cpumons/OTTOdiy/OttoDIY_PLUS_all/05_Papercraft & share/OttoDIY_papercraft_captain_A4.jpg

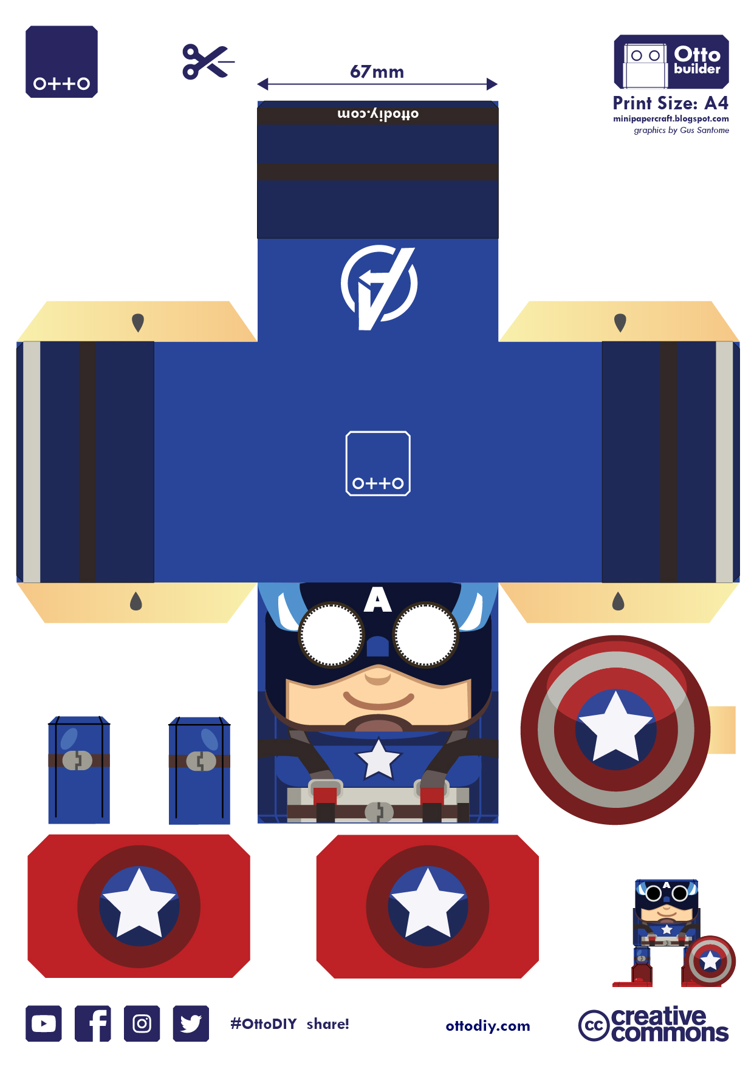
OttoDIY_PLUS_all/05_Papercraft & share/OttoDIY_papercraft_captain_A4.jpg
