cpumons/OTTOdiy/OttoDIY_PLUS_all/05_Papercraft & share/OttoDIY_papercraft_ironman_A4.jpg

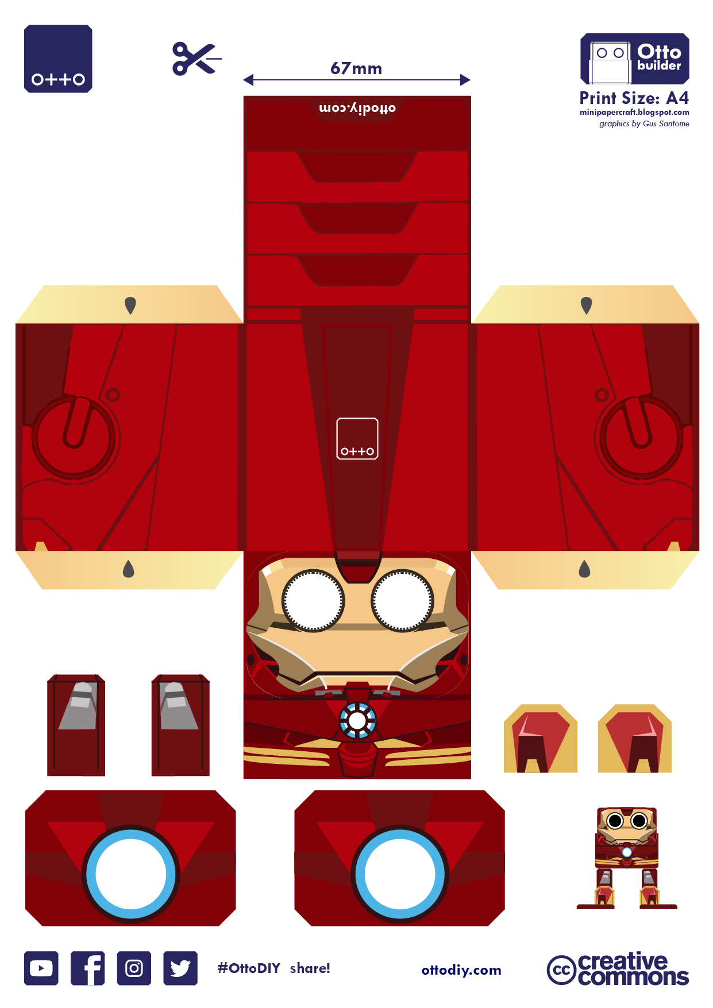
OttoDIY_PLUS_all/05_Papercraft & share/OttoDIY_papercraft_ironman_A4.jpg
