cpumons/OTTOdiy/OttoDIY_PLUS_all/05_Papercraft & share/OttoDIY_papercraft_minion_A4.jpg.jpg

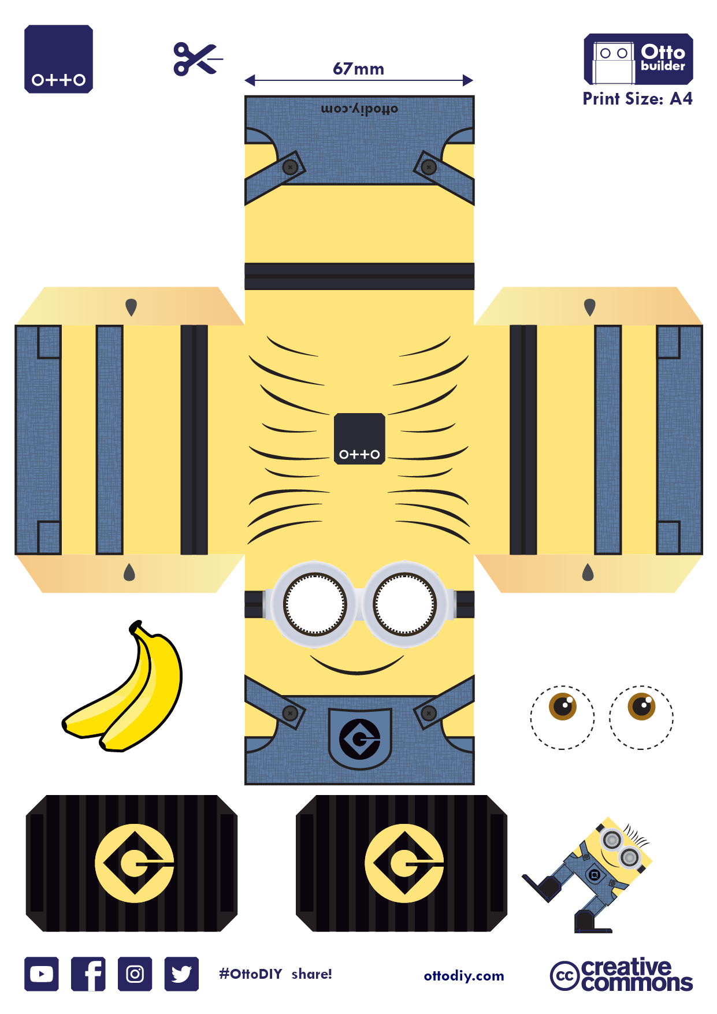
OttoDIY_PLUS_all/05_Papercraft & share/OttoDIY_papercraft_minion_A4.jpg.jpg
