cpumons/OTTOdiy/OttoDIY_PLUS_all/3D print/accessories/OttoDIY_Elf.stl

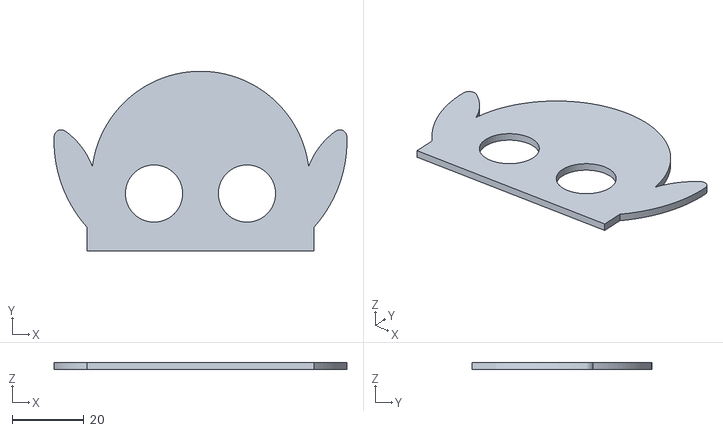
[picture p14: CAD file, 2019-02-06]
OttoDIY_PLUS_all/3D print/accessories/OttoDIY_Elf.stl
81.9 x 50.2 x 2.00
