cpumons/OTTOdiy/OttoDIY_PLUS_all/3D print/OttoDIY+_body_v08.stl

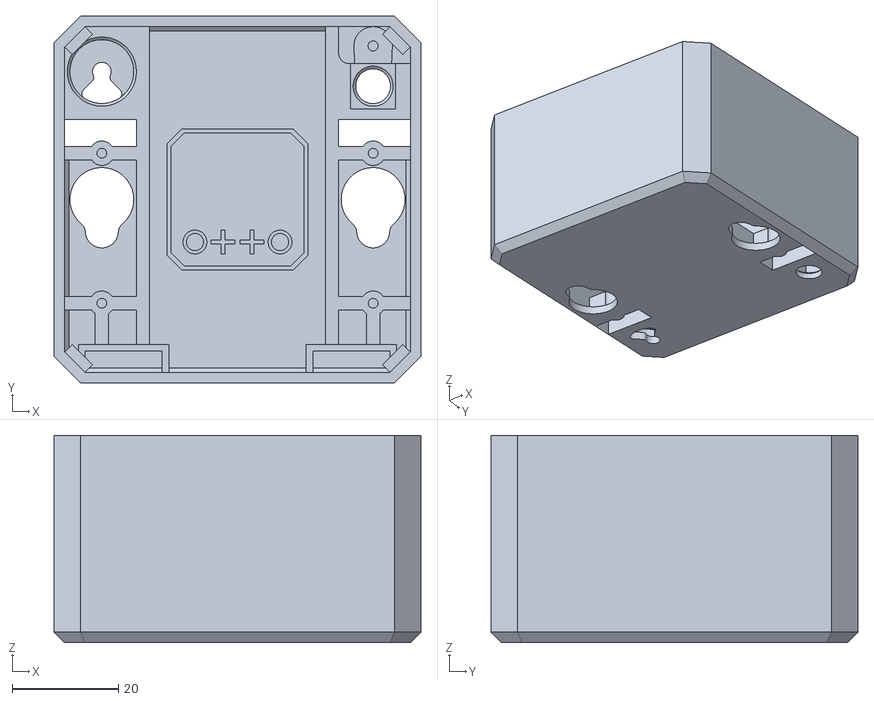
[picture p15: CAD file, 2019-02-06]
OttoDIY_PLUS_all/3D print/OttoDIY+_body_v08.stl
69.0 x 69.0 x 39.0
