cpumons/OTTOdiy/OttoDIY_PLUS_all/3D print/accessories/OttoDIY_Stitches.stl

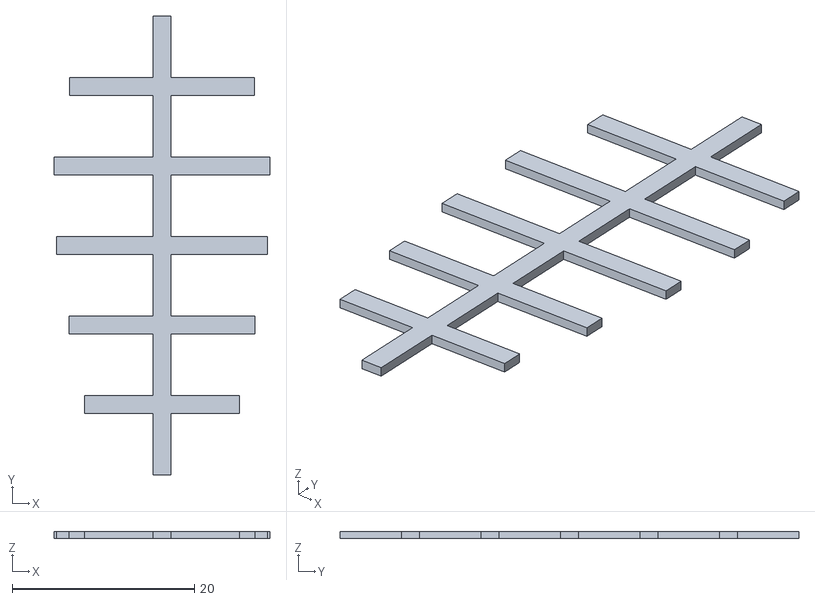
[picture p16: CAD file, 2019-02-06]
OttoDIY_PLUS_all/3D print/accessories/OttoDIY_Stitches.stl
23.7 x 50.3 x 0.8
