cpumons/OTTOdiy/OttoDIY_PLUS_all/3D print/OttoDIY+_head_v08.stl

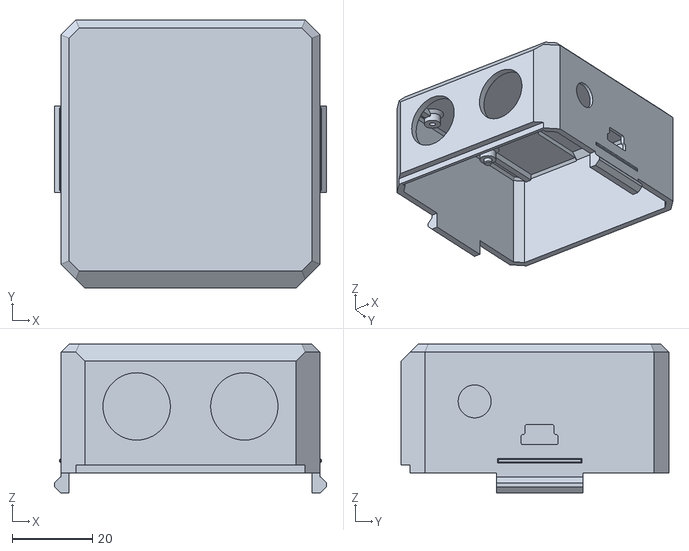
[picture p17: CAD file, 2019-02-06]
OttoDIY_PLUS_all/3D print/OttoDIY+_head_v08.stl
67.6 x 66.7 x 37.0
