cpumons/OTTOdiy/OttoDIY_PLUS_all/3D print/accessories/OttoDIY_superhero.stl

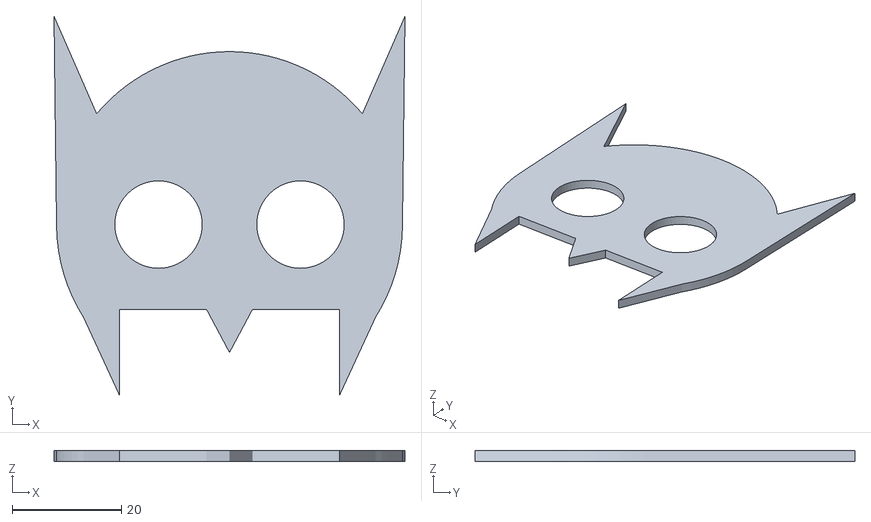
[picture p18: CAD file, 2019-02-06]
OttoDIY_PLUS_all/3D print/accessories/OttoDIY_superhero.stl
64.3 x 69.5 x 2.00
