cpumons/OTTOdiy/OttoDIY_PLUS_all/3D print/OttoDIY+_Leg_v08.stl

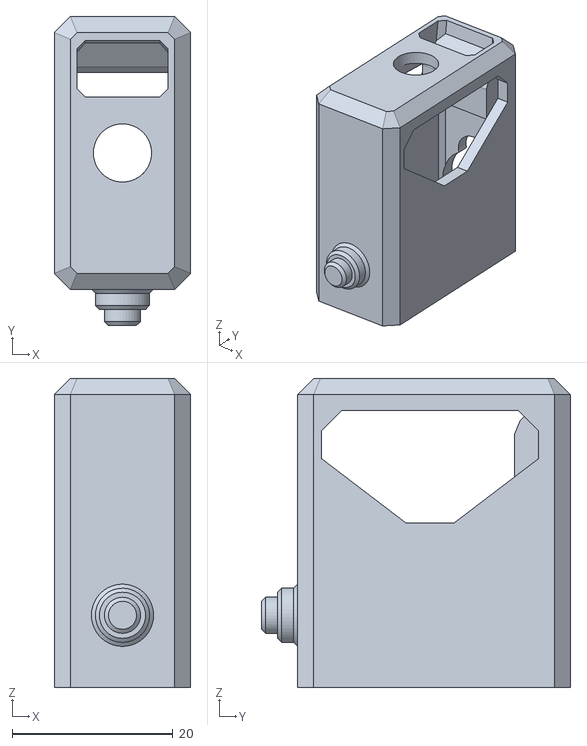
[picture p19: CAD file, 2019-02-06]
OttoDIY_PLUS_all/3D print/OttoDIY+_Leg_v08.stl
17.0 x 38.5 x 38.5
