cpumons/OTTOdiy/OttoDIY_PLUS_all/3D print/accessories/OttoDIY_Kitty.stl

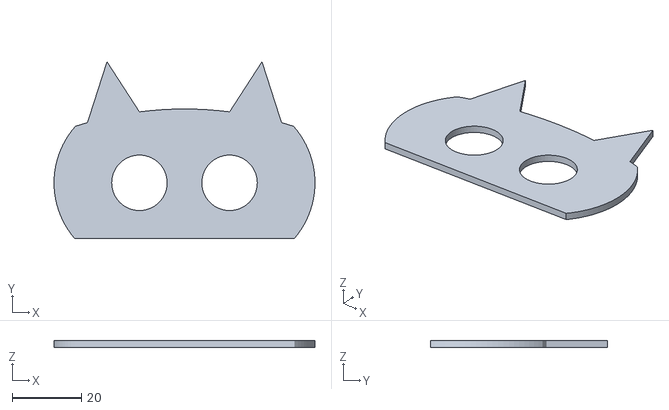
[picture p20: CAD file, 2019-02-06]
OttoDIY_PLUS_all/3D print/accessories/OttoDIY_Kitty.stl
75.3 x 50.9 x 2.00
