cpumons/OTTOdiy/OttoDIY_PLUS_all/3D print/OttoDIY+_foot_v08.stl

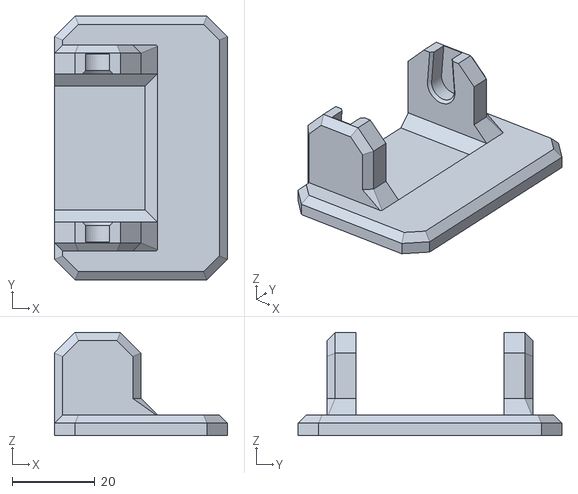
[picture p21: CAD file, 2019-02-06]
OttoDIY_PLUS_all/3D print/OttoDIY+_foot_v08.stl
42.0 x 64.0 x 25.0
