cpumons/OTTOdiy/OttoDIY_PLUS_all/3D print/accessories/OttoDIY_Skull.stl

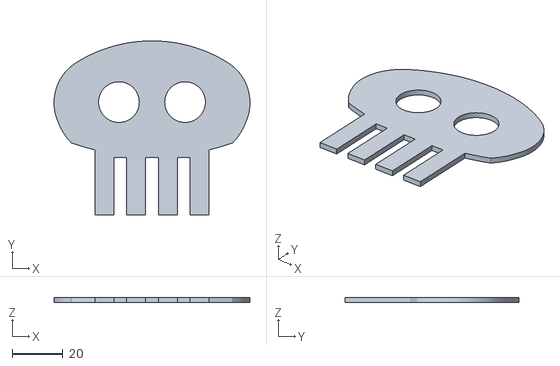
[picture p22: CAD file, 2019-02-06]
OttoDIY_PLUS_all/3D print/accessories/OttoDIY_Skull.stl
77.1 x 68.4 x 2.00
