cpumons/OTTOdiy/OttoDIY_PLUS_all/3D print/accessories/OttoDIY_RockMonster.stl

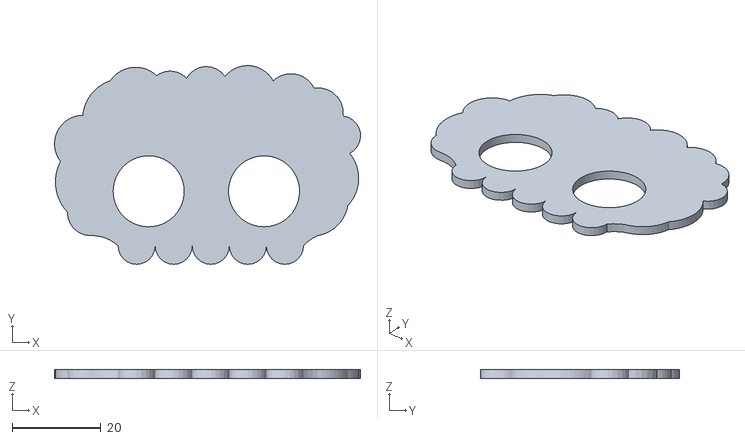
[picture p23: CAD file, 2019-02-06]
OttoDIY_PLUS_all/3D print/accessories/OttoDIY_RockMonster.stl
69.0 x 44.8 x 2.00
