cpumons/OTTOdiy/OttoDIY_PLUS_all/3D print/accessories/OttoDIY_Bunny.stl

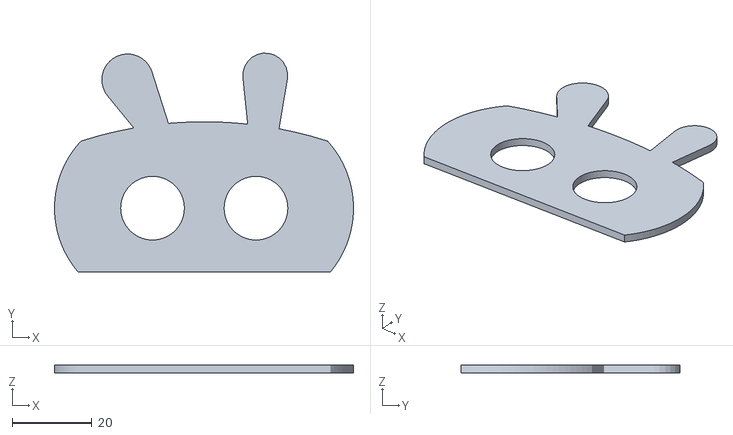
[picture p24: CAD file, 2019-02-06]
OttoDIY_PLUS_all/3D print/accessories/OttoDIY_Bunny.stl
75.1 x 55.0 x 2.00
