cpumons/OTTOdiy/OttoDIY_PLUS_all/3D print/accessories/OttoDIY_glasses.stl

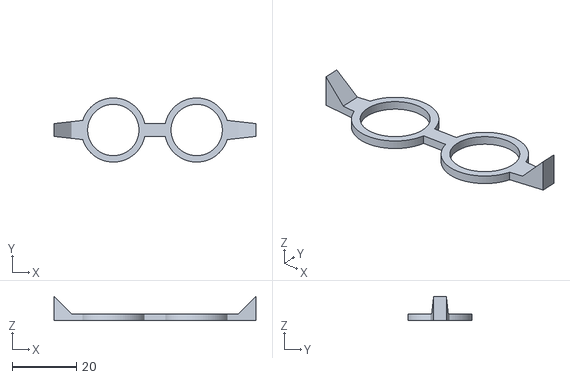
[picture p25: CAD file, 2019-02-06]
OttoDIY_PLUS_all/3D print/accessories/OttoDIY_glasses.stl
63.0 x 20.0 x 7.50
