cpumons/OTTOdiy/OttoDIY_PLUS_all/3D print/accessories/OttoDIY_lashes.stl

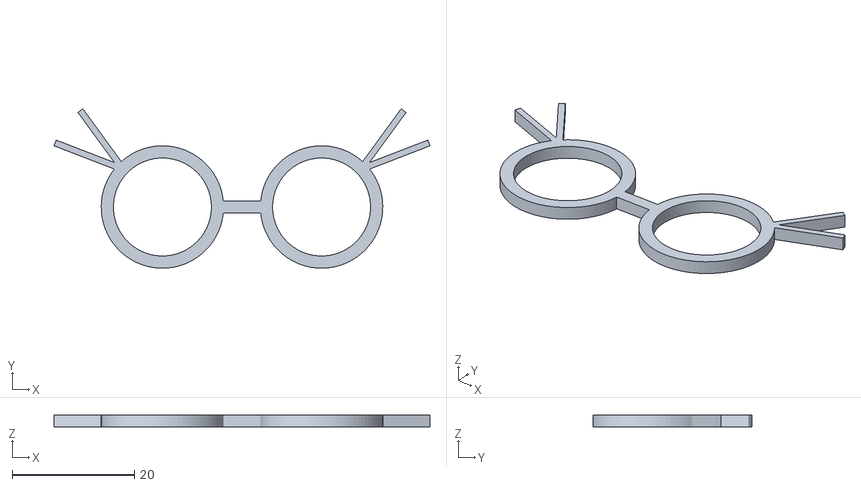
[picture p26: CAD file, 2019-02-06]
OttoDIY_PLUS_all/3D print/accessories/OttoDIY_lashes.stl
61.4 x 26.0 x 2.00
