cpumons/OTTOdiy/OttoDIY_PLUS_all/3D print/accessories/OttoDIY_AngryEyes.stl

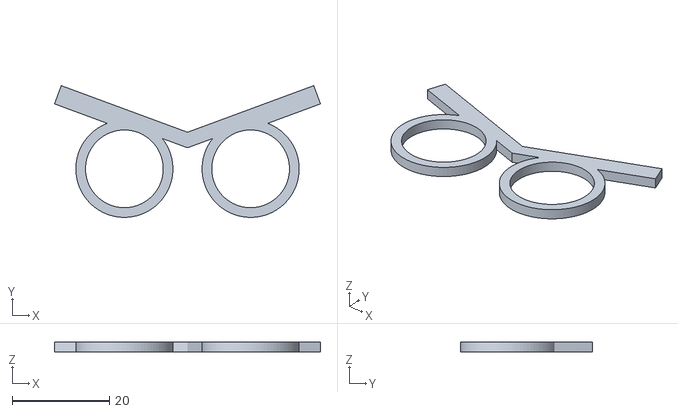
[picture p27: CAD file, 2019-02-06]
OttoDIY_PLUS_all/3D print/accessories/OttoDIY_AngryEyes.stl
54.8 x 27.1 x 2.00
