cpumons/OTTOdiy/OttoDIY_PLUS_all/3D print/accessories/OttoDIY_notHero.stl

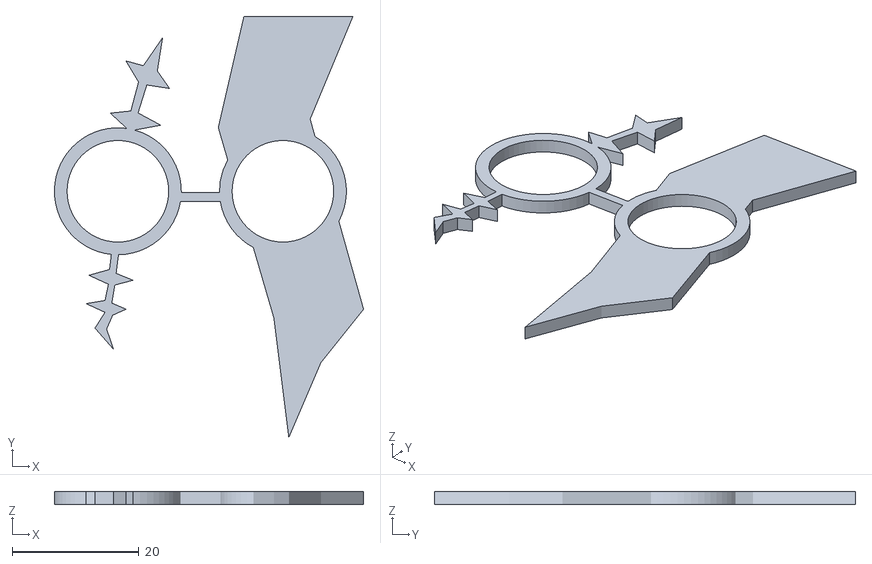
[picture p28: CAD file, 2019-02-06]
OttoDIY_PLUS_all/3D print/accessories/OttoDIY_notHero.stl
48.7 x 66.3 x 2.00
