cpumons/OTTOdiy/OttoDIY_PLUS_all/3D print/accessories/OttoDIY_pirate.stl

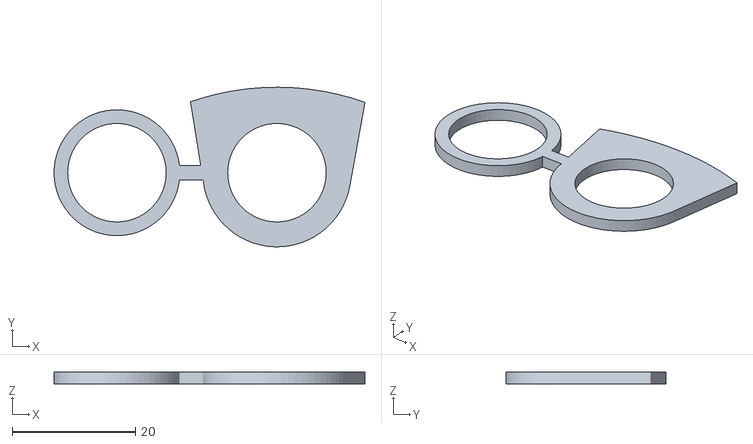
[picture p29: CAD file, 2019-02-06]
OttoDIY_PLUS_all/3D print/accessories/OttoDIY_pirate.stl
50.5 x 25.9 x 2.00
