cpumons/OTTOdiy/OttoDIY_PLUS_all/3D print/accessories/OttoDIY_superhero2.stl

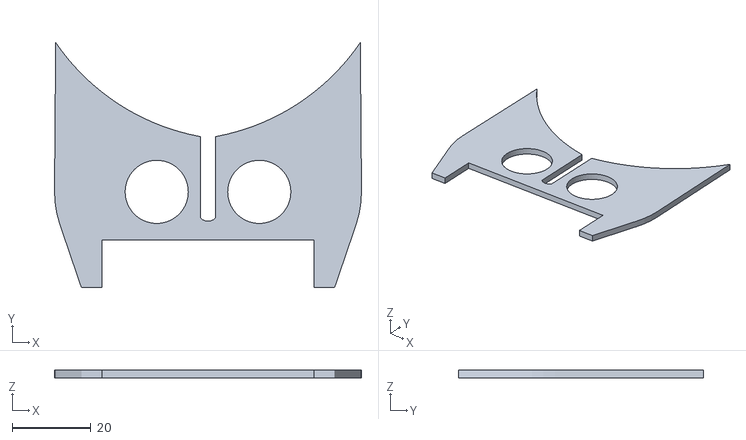
[picture p30: CAD file, 2019-02-06]
OttoDIY_PLUS_all/3D print/accessories/OttoDIY_superhero2.stl
77.8 x 62.1 x 2.00
