cpumons/OTTOdiy/OttoDIY_PLUS_all/3D print/accessories/OttoDIY_PumpkinMonster.stl

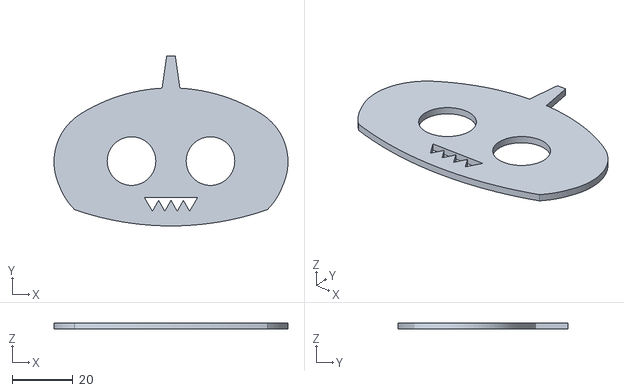
[picture p31: CAD file, 2019-02-06]
OttoDIY_PLUS_all/3D print/accessories/OttoDIY_PumpkinMonster.stl
77.1 x 55.9 x 2.00
