cpumons/OTTOdiy/OttoDIY_PLUS_all/3D print/accessories/OttoDIY_Puppy.stl

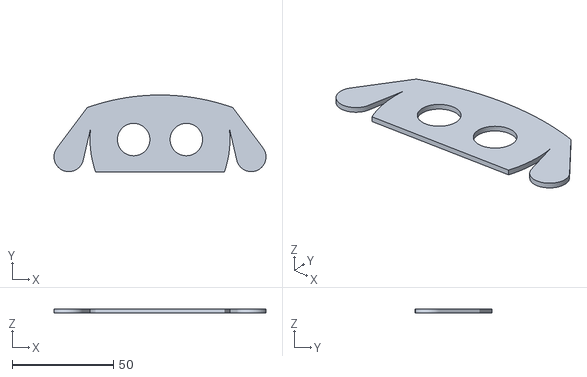
[picture p32: CAD file, 2019-02-06]
OttoDIY_PLUS_all/3D print/accessories/OttoDIY_Puppy.stl
104.6 x 38.0 x 2.00
