cpumons/OTTOdiy/OttoDIY_PLUS_all/3D print/accessories/OttoDIY_WarMask.stl

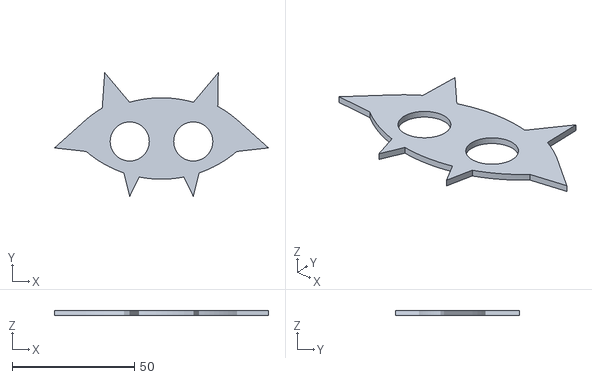
[picture p33: CAD file, 2019-02-06]
OttoDIY_PLUS_all/3D print/accessories/OttoDIY_WarMask.stl
87.6 x 50.6 x 2.00
