cpumons/OTTOdiy/OttoDIY_PLUS_all/3D print/accessories/OttoDIY_Ninja.stl

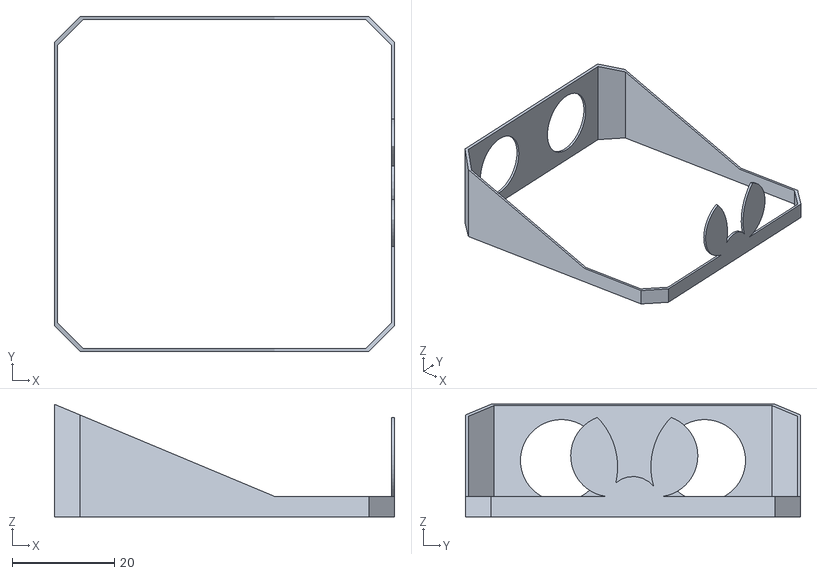
[picture p34: CAD file, 2019-02-06]
OttoDIY_PLUS_all/3D print/accessories/OttoDIY_Ninja.stl
66.5 x 65.5 x 22.0
