cpumons/OTTOdiy/OttoDIY_PLUS_all/OttoDIY+_InstructionsManual_V05.pdf

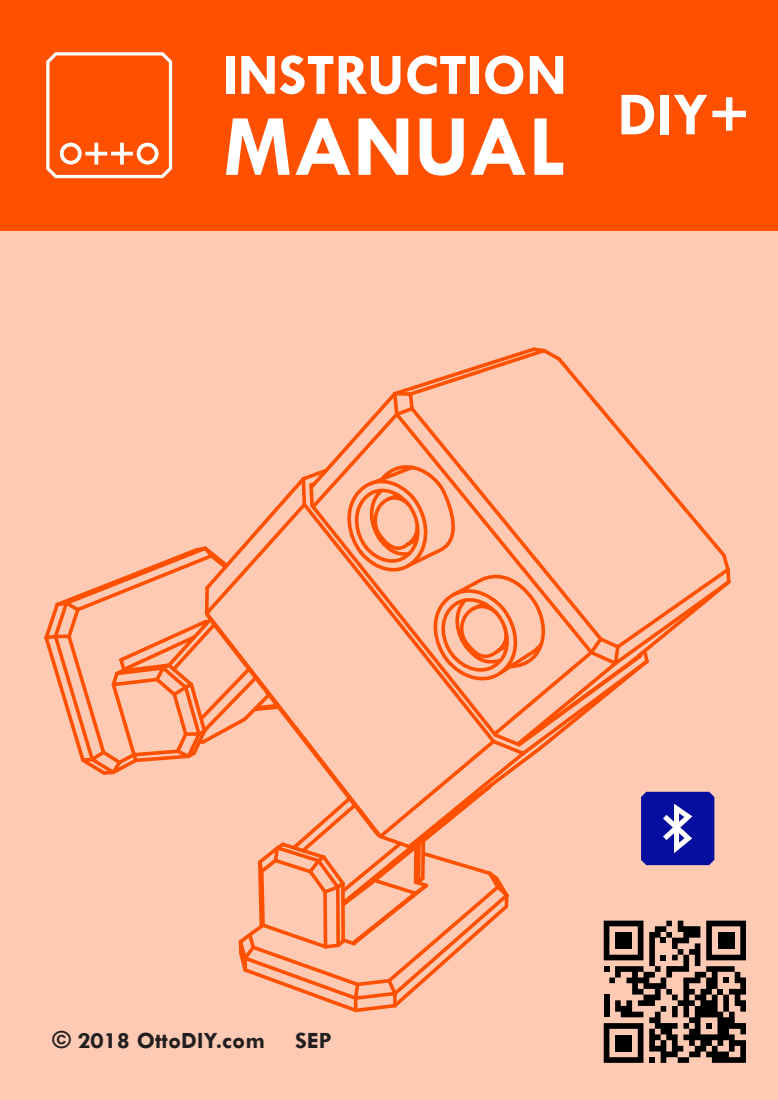
[picture p35: page 1]

© 2018 OttoDIY.com SEP

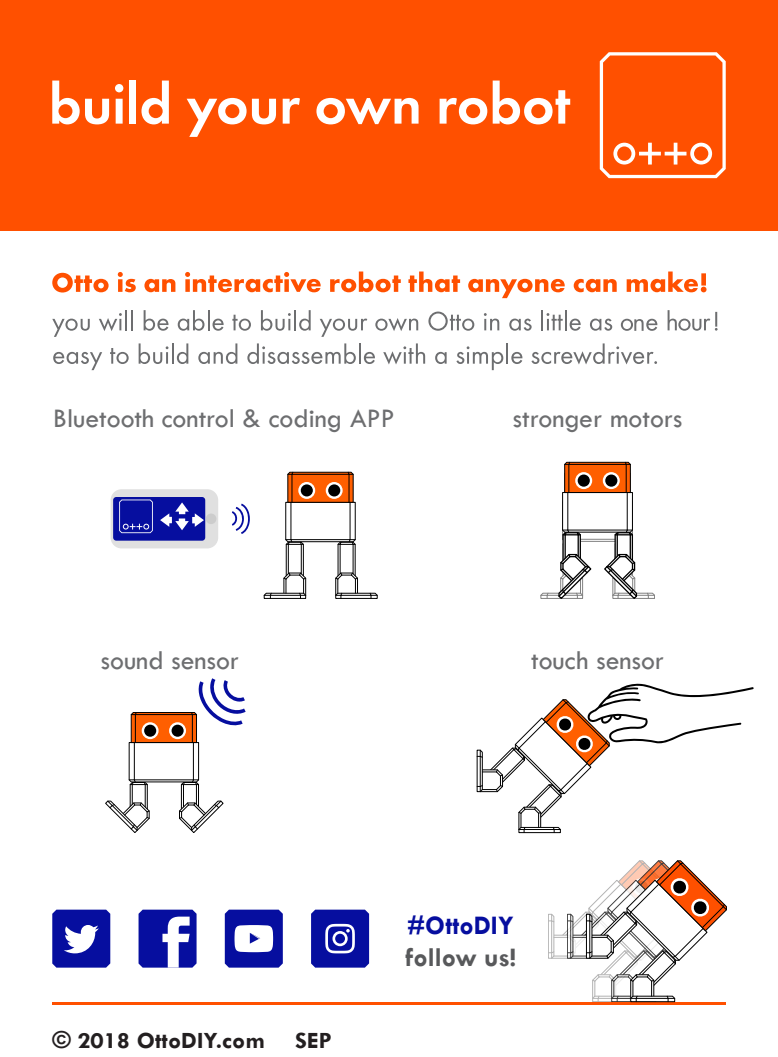
[picture p36: page 2]
sound sensor; touch sensor; stronger motors; #OttoDIY follow us!

Bluetooth control & coding APP

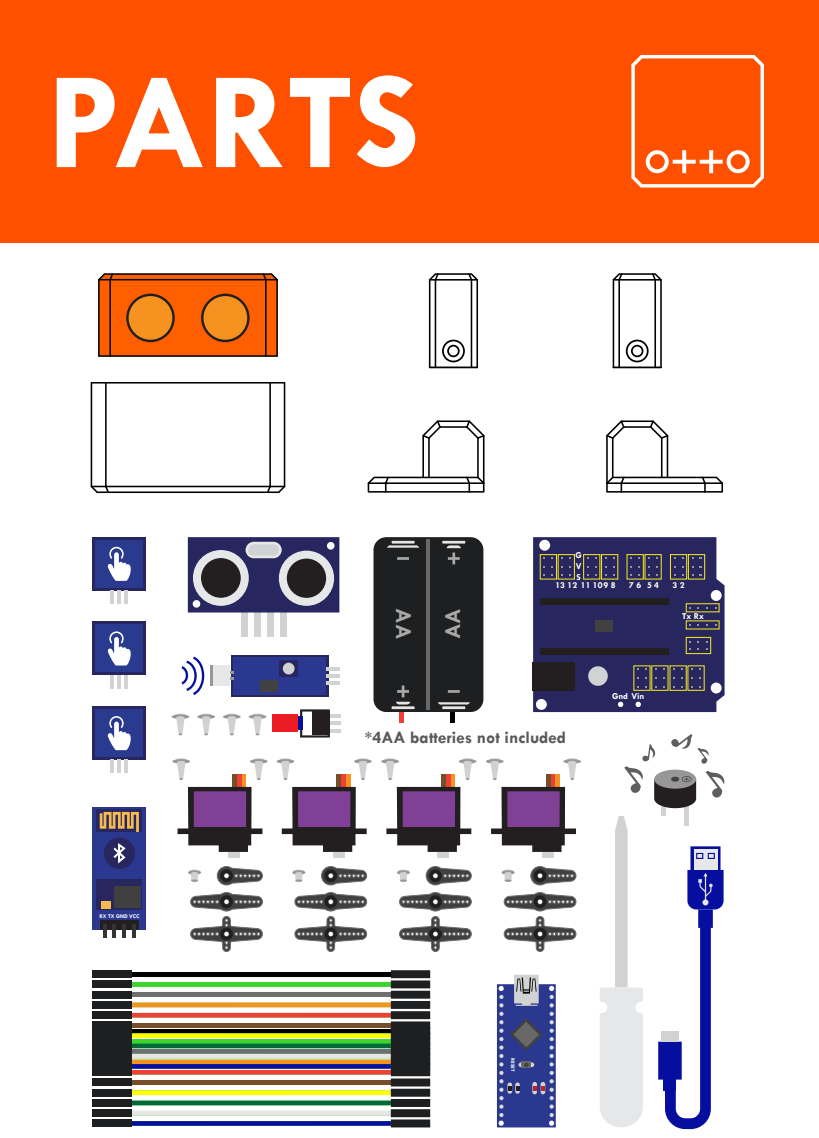
[picture p37: page 3]
Gnd Vin

*4AA batteries not included RESET

RX TX GND VCC

a

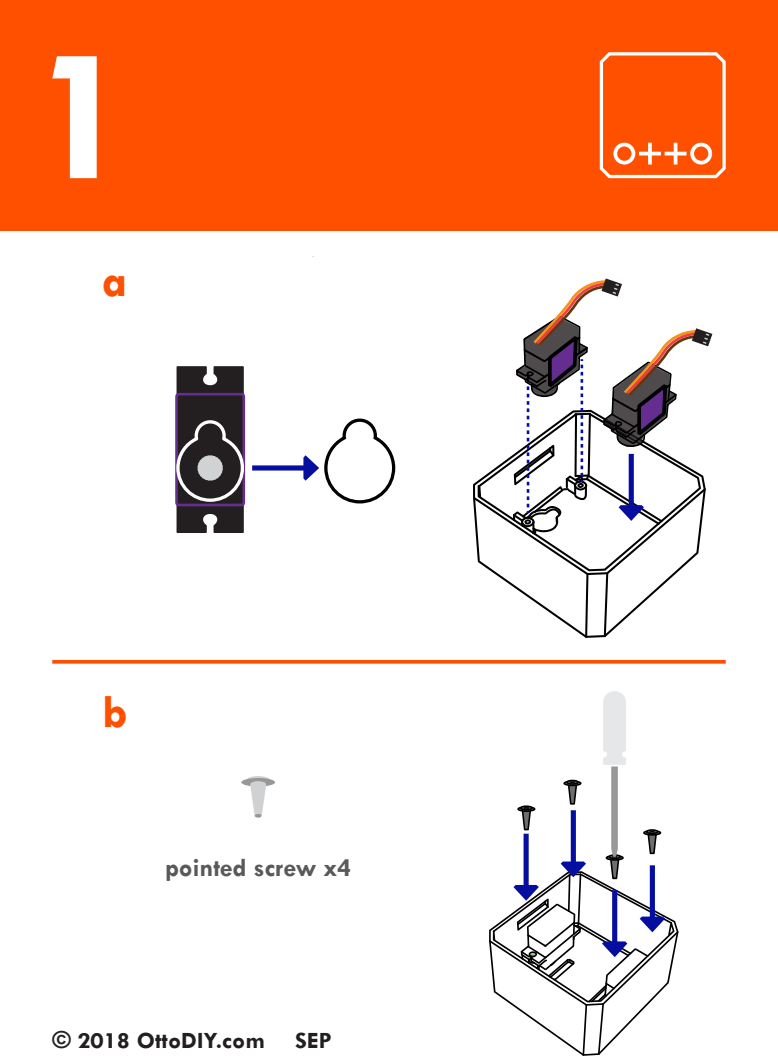
[picture p38: page 4]
pointed screw x4

a

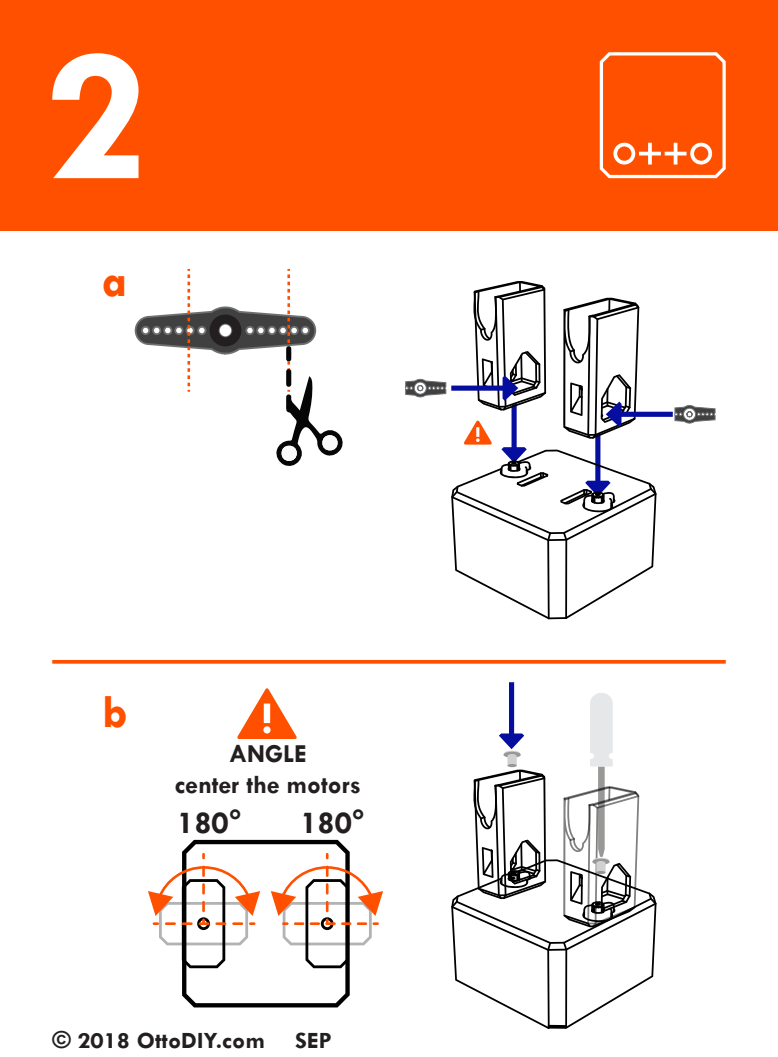
[picture p39: page 5]

ANGLE
center the motors

a

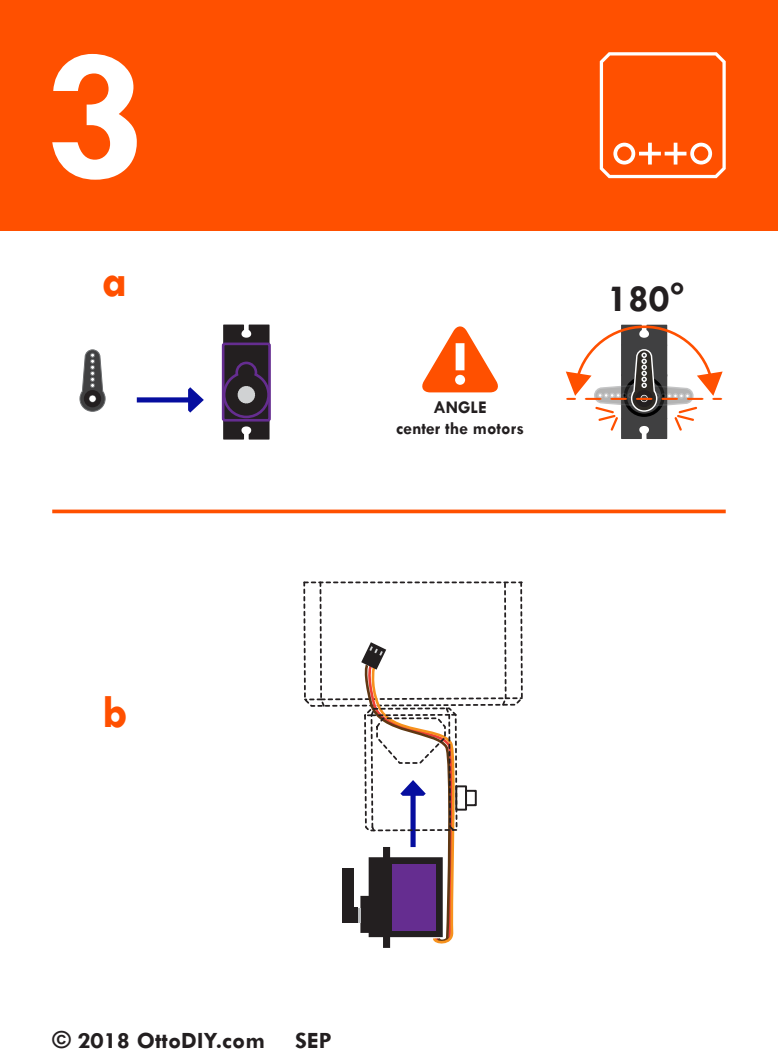
[picture p40: page 6]

ANGLE
center the motors

a

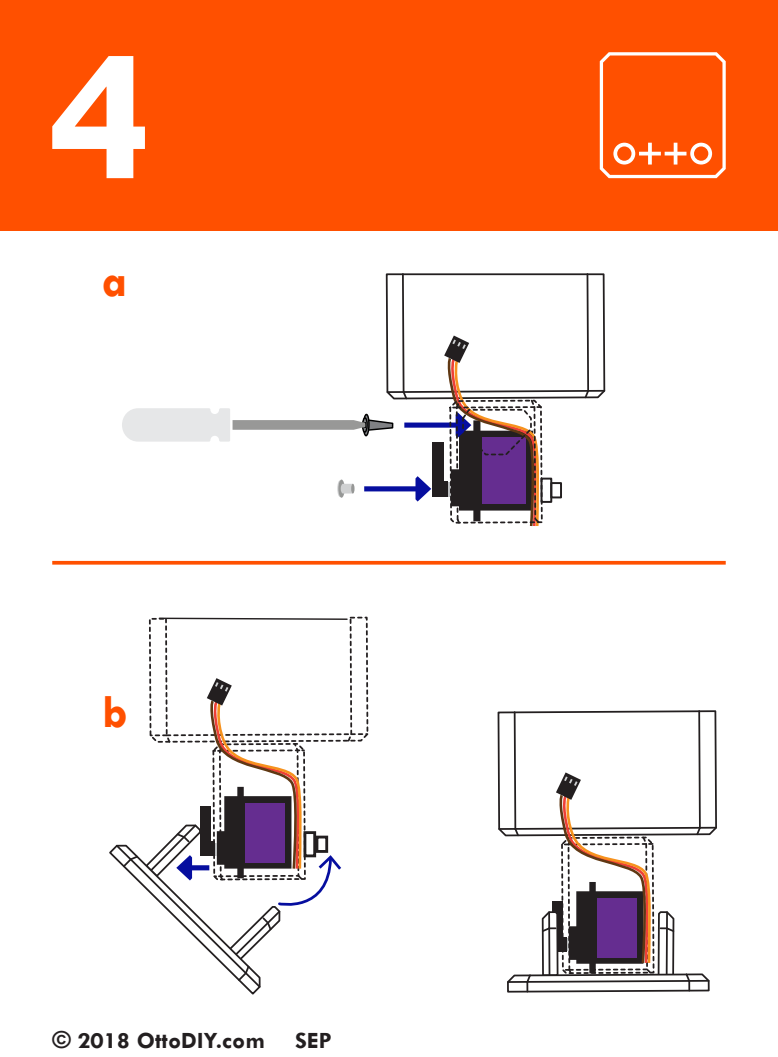
[picture p41: page 7]

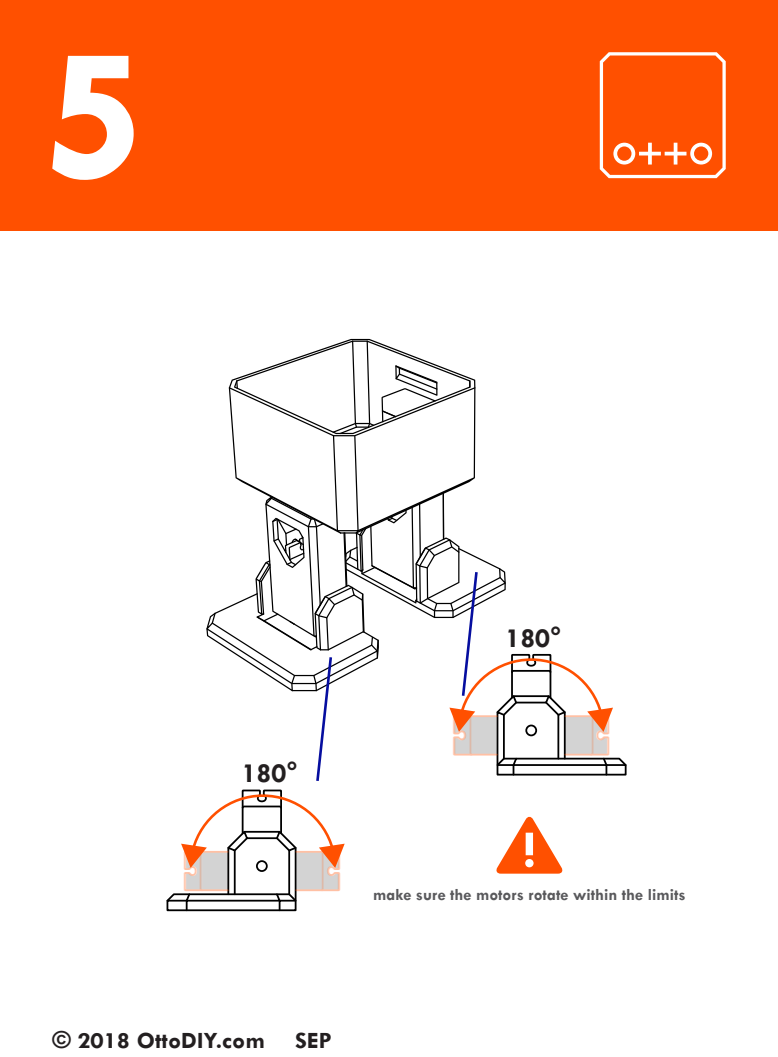
[picture p42: page 8]

make sure the motors rotate within the limits

a

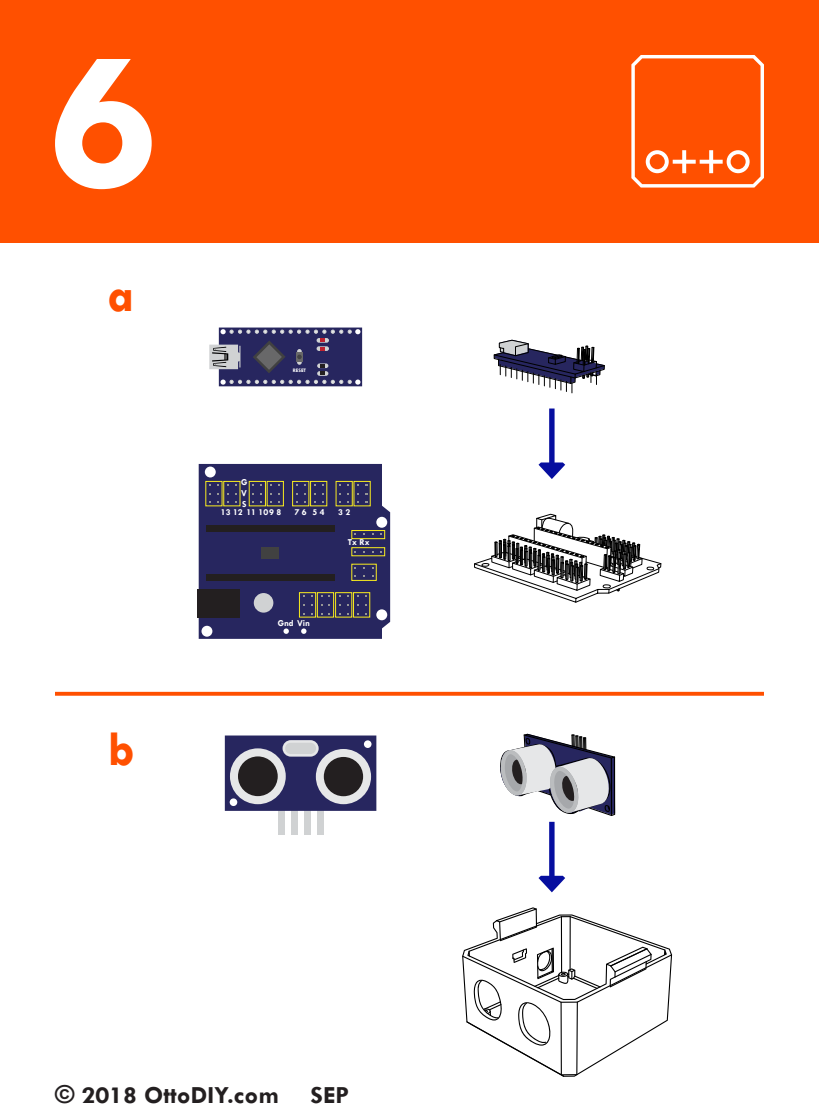
[picture p43: page 9]
RESET; Gnd Vin

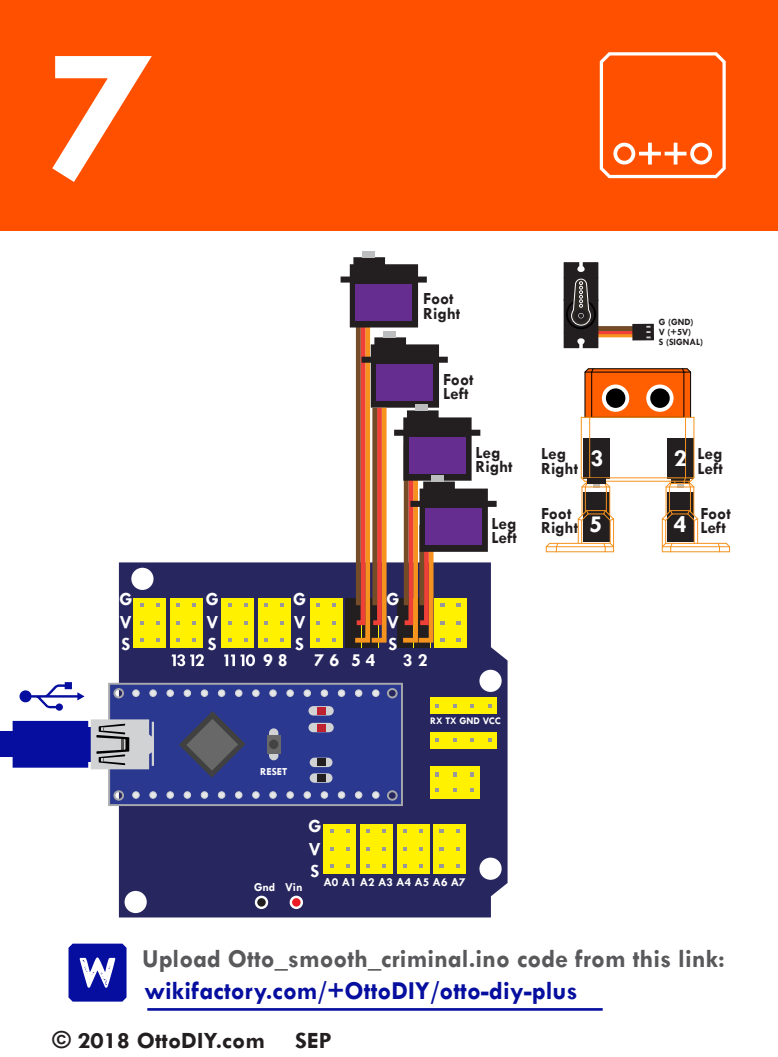
[picture p44: page 10]
RESET; Gnd Vin; Foot Right; Leg; Left Leg Right; Foot Left; G (GND) V (+5V) S (SIGNAL); Leg Left; Leg Right

RX TX GND VCC

Upload Otto_smooth_criminal.ino code from this link:
wikifactory.com/+OttoDIY/otto-diy-plus

a

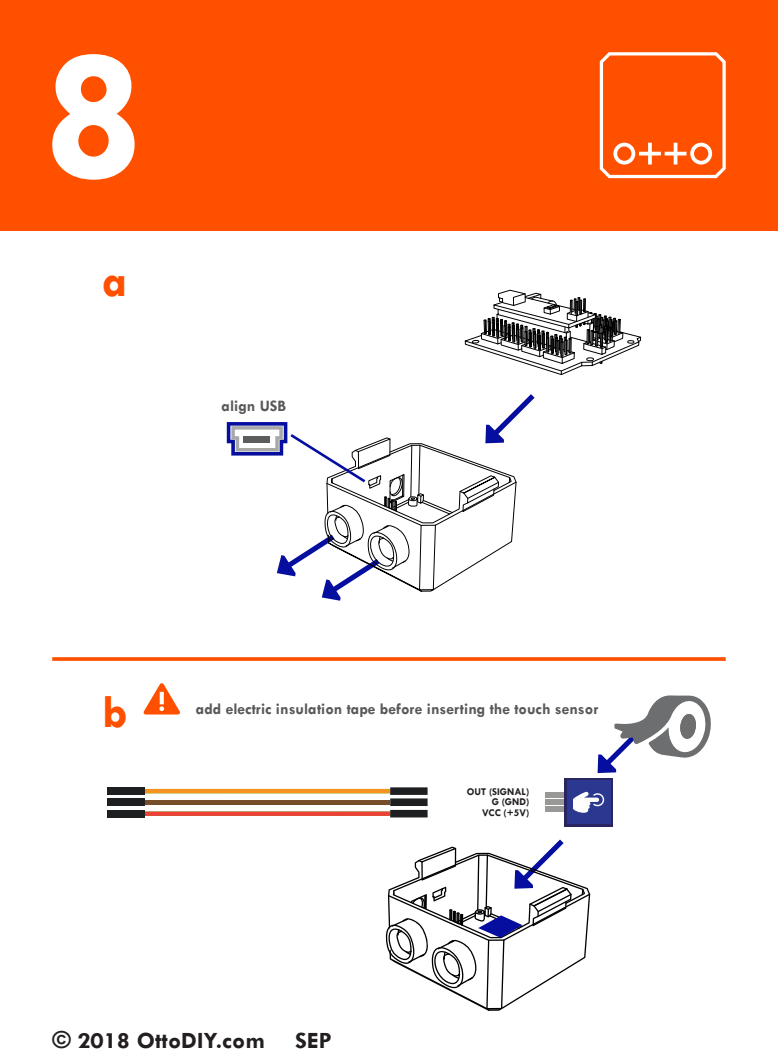
[picture p45: page 11]
align USB; OUT (SIGNAL) G (GND) VCC (+5V)

add electric insulation tape before inserting the touch sensor

a

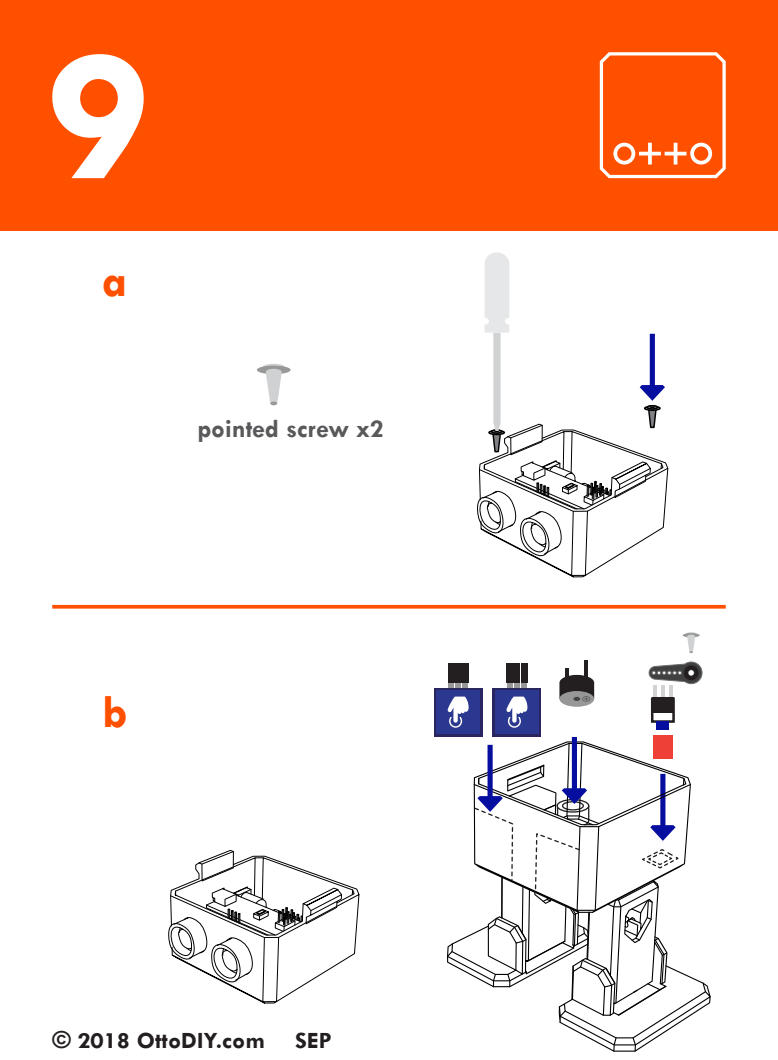
[picture p46: page 12]
pointed screw x2

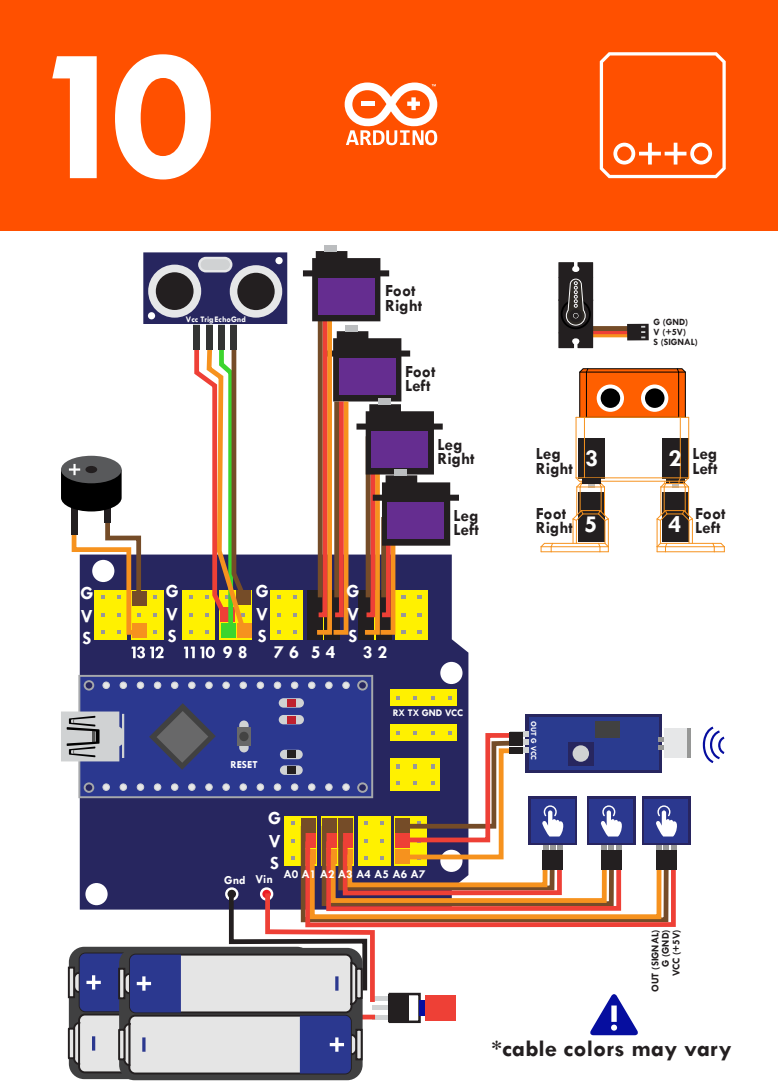
[picture p47: page 13]
Gnd Vin; OUT G VCC; Vcc TrigEchoGnd; OUT (SIGNAL); G (GND); VCC (+5V); Foot Right; Leg Left; Leg Right; Foot Left; Leg; Left Leg Right; G (GND) V (+5V) S (SIGNAL); RESET

RX TX GND VCC

*cable colors may vary

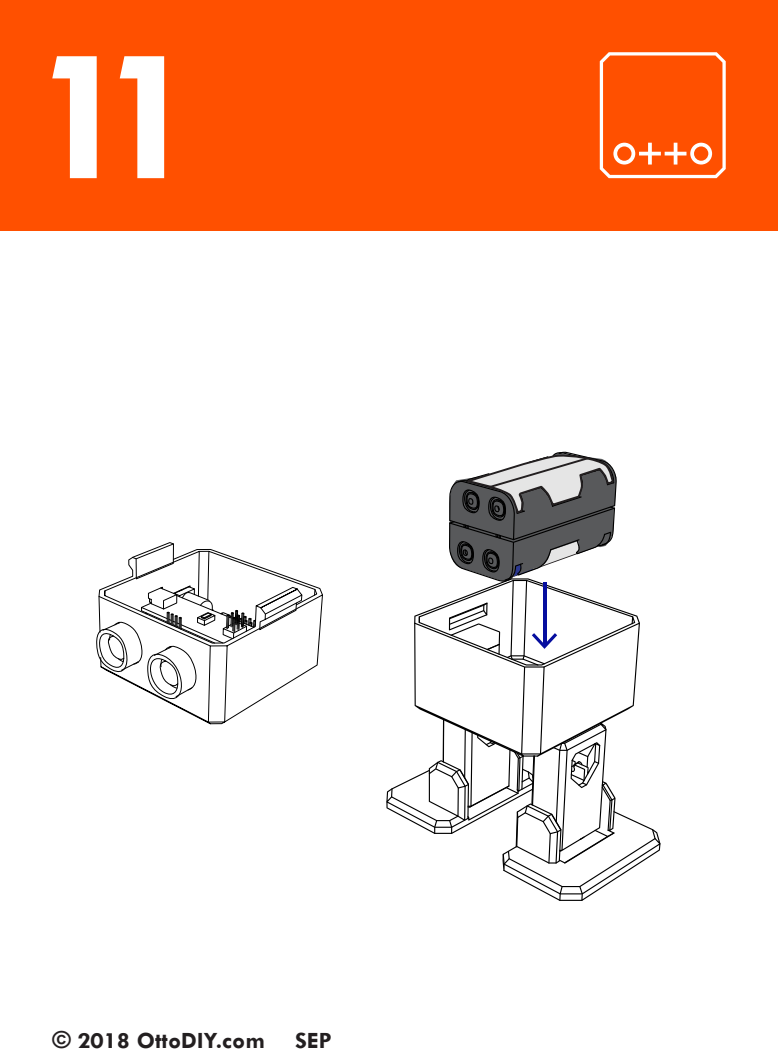
[picture p48: page 14]

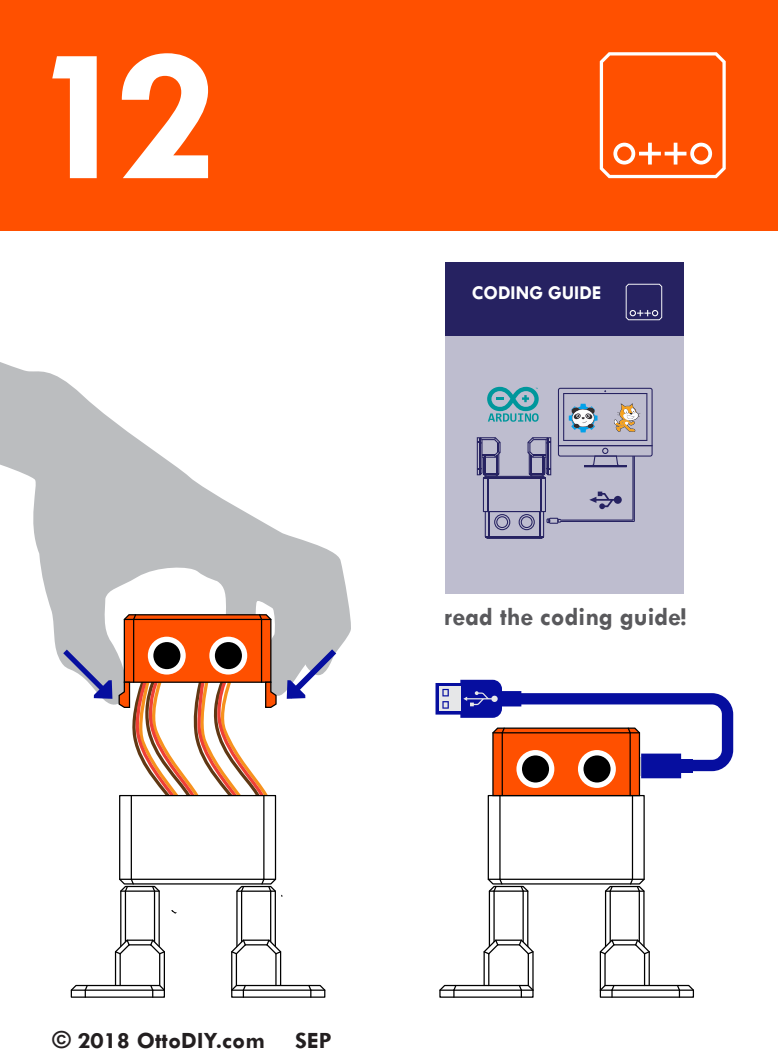
[picture p49: page 15]
CODING GUIDE

read the coding guide!

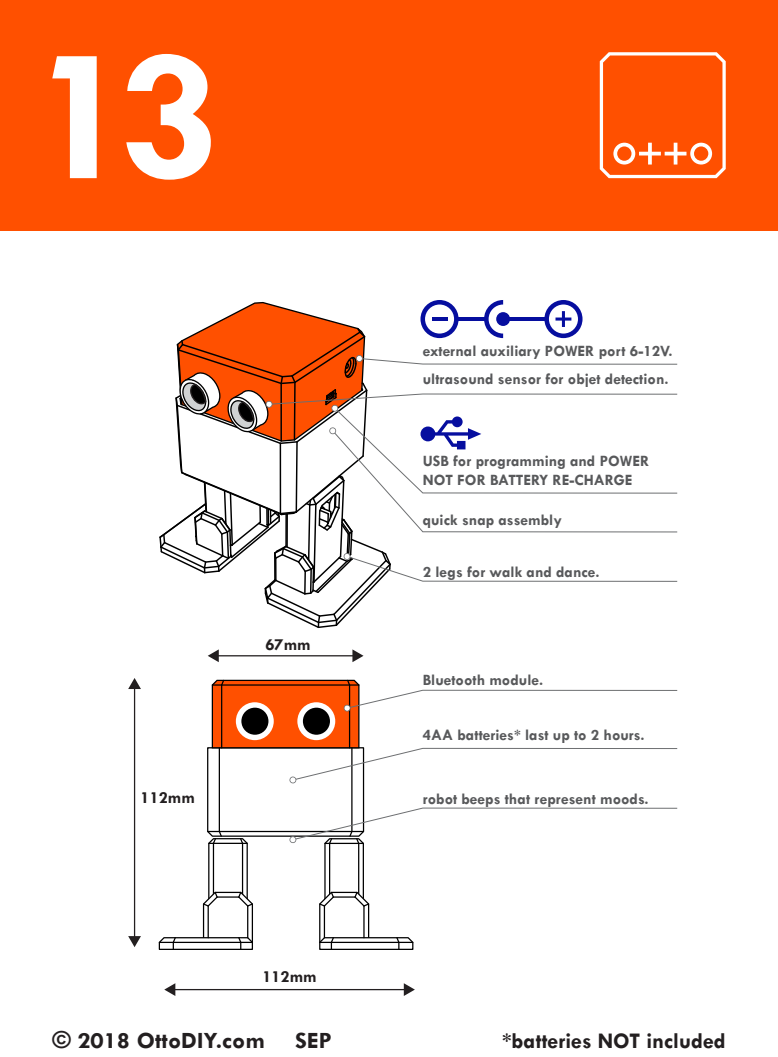
[picture p50: page 16]
Bluetooth module.; © 2018 OttoDIY.com SEP; *batteries NOT included

external auxiliary POWER port 6-12V.
ultrasound sensor for objet detection.

USB for programming and POWER
NOT FOR BATTERY RE-CHARGE

quick snap assembly

2 legs for walk and dance.

4AA batteries* last up to 2 hours.

robot beeps that represent moods.

a

# SIGN UP in ottodiy.com

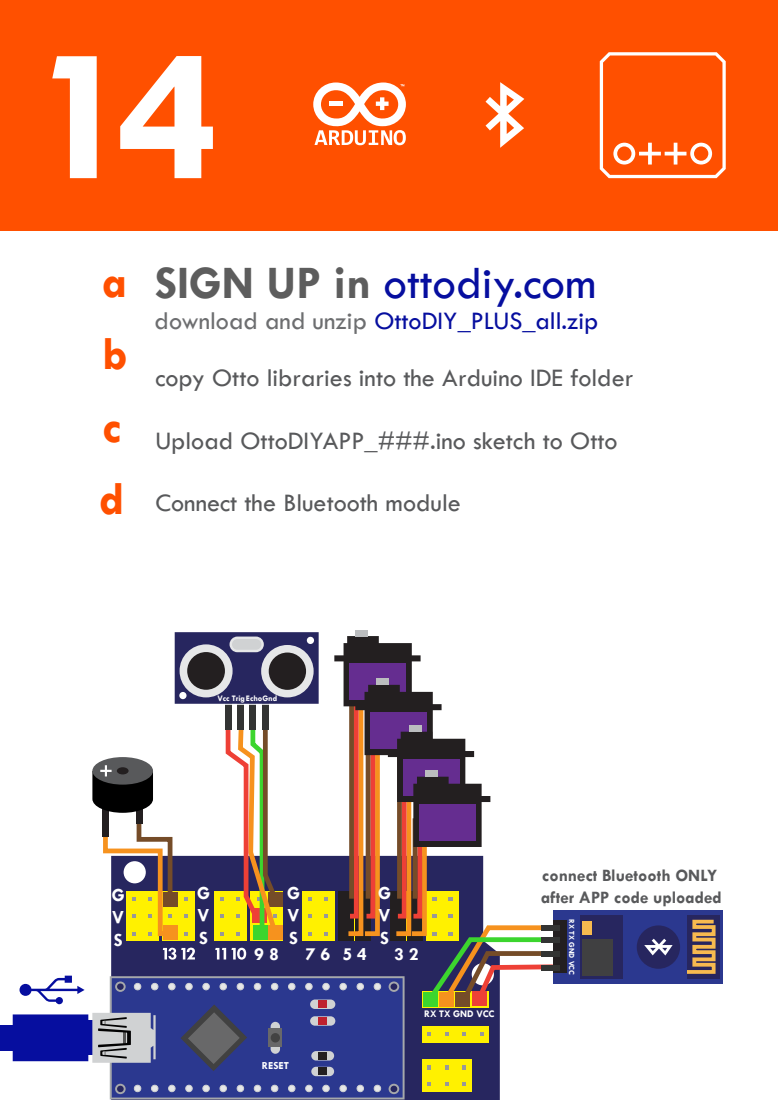
[picture p51: page 17]
Vcc TrigEchoGnd; RESET

download and unzip OttoDIY_PLUS_all.zip
copy Otto libraries into the Arduino IDE folder
Upload OttoDIYAPP_###.ino sketch to Otto
Connect the Bluetooth module

connect Bluetooth ONLY
after APP code uploaded RX TX GND VCC

RX TX GND VCC

d

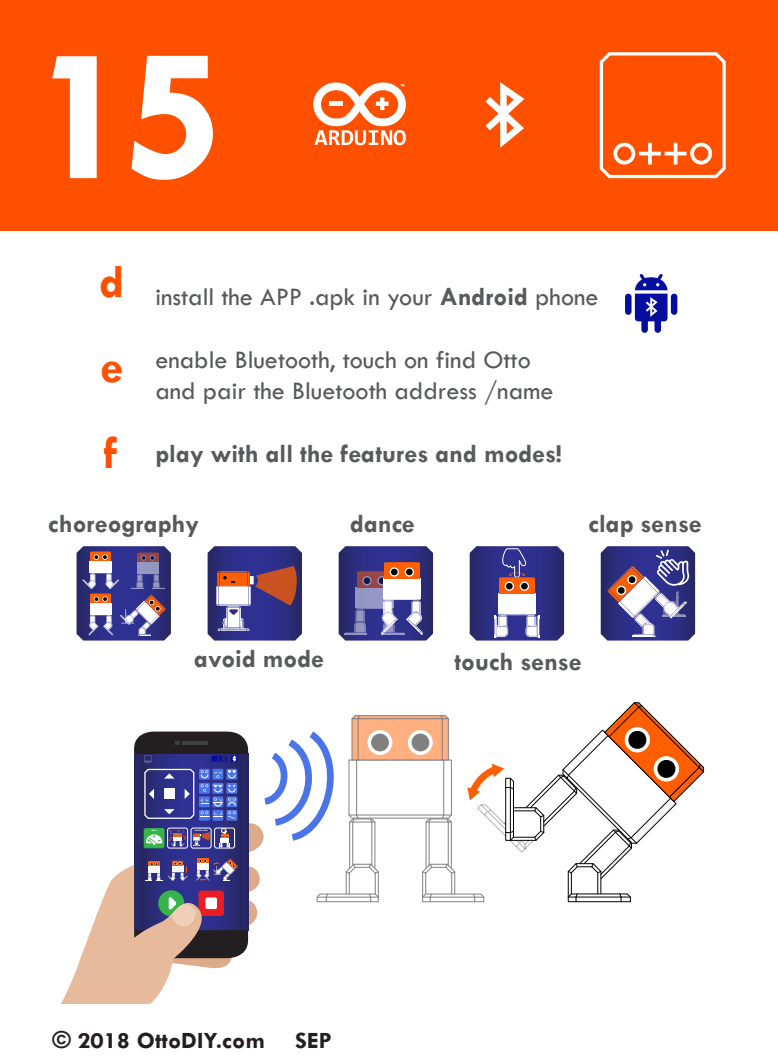
[picture p52: page 18]
slow; avoid mode; dance; touch sense; choreography; clap sense

install the APP .apk in your Android phone
enable Bluetooth, touch on find Otto
and pair the Bluetooth address /name
play with all the features and modes!

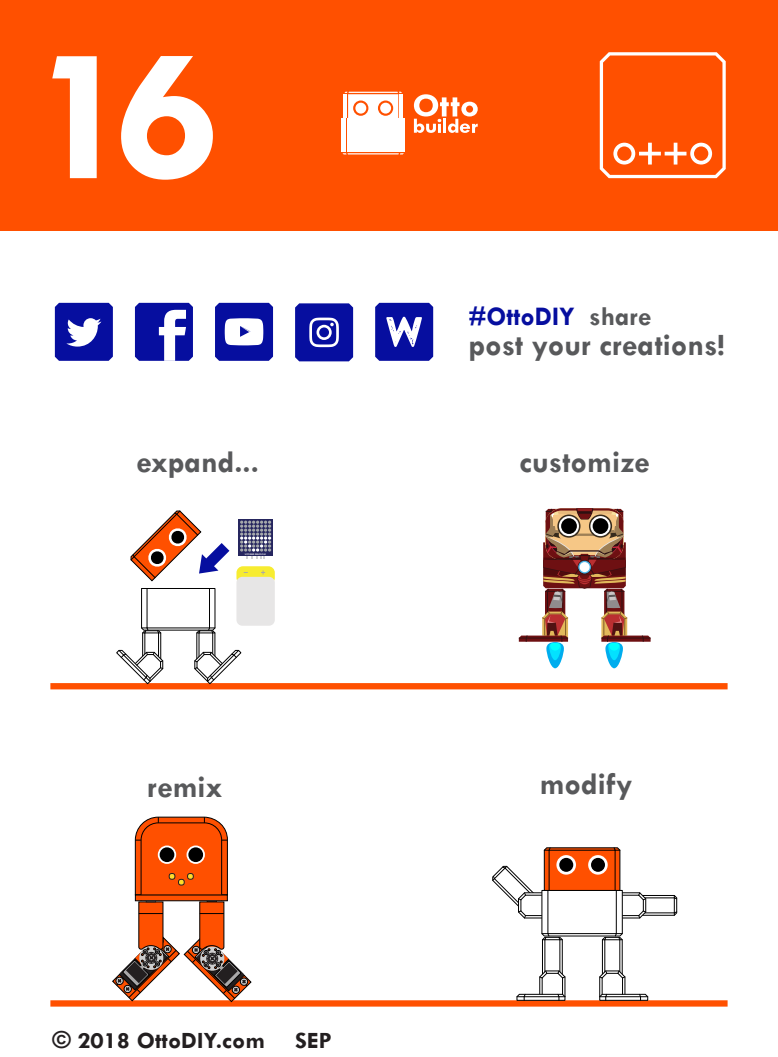
[picture p53: page 19]
remix; expand...; customize; modify

#OttoDIY share
post your creations!

VCC GND DINCSCLK

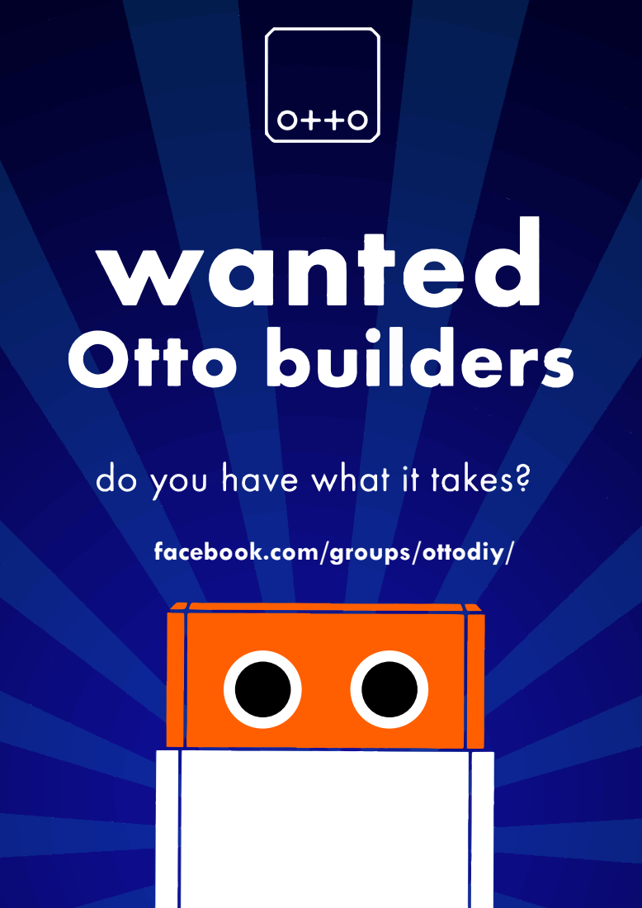
[picture p54: page 20]

facebook.com/groups/ottodiy/
