cpumons/OTTOdiy/OttoDIY_PLUS_all/OttoDIY_InstructionsManual_V09.PDF

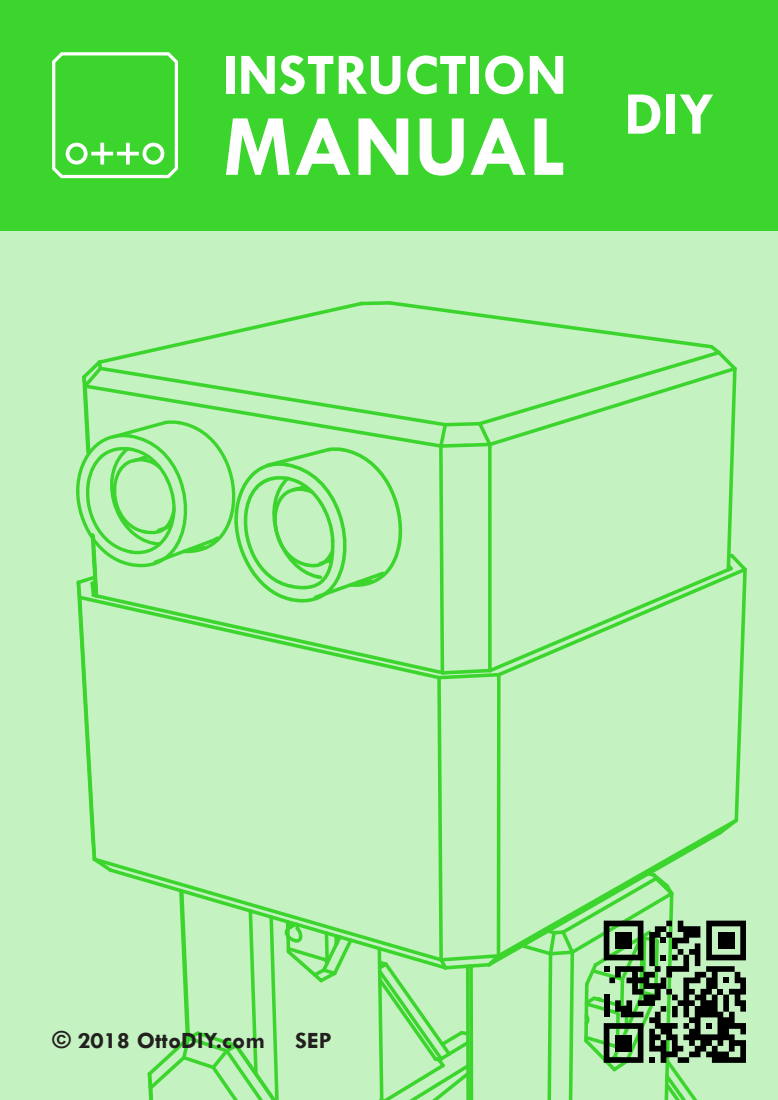
[picture p55: page 1]

© 2018 OttoDIY.com SEP

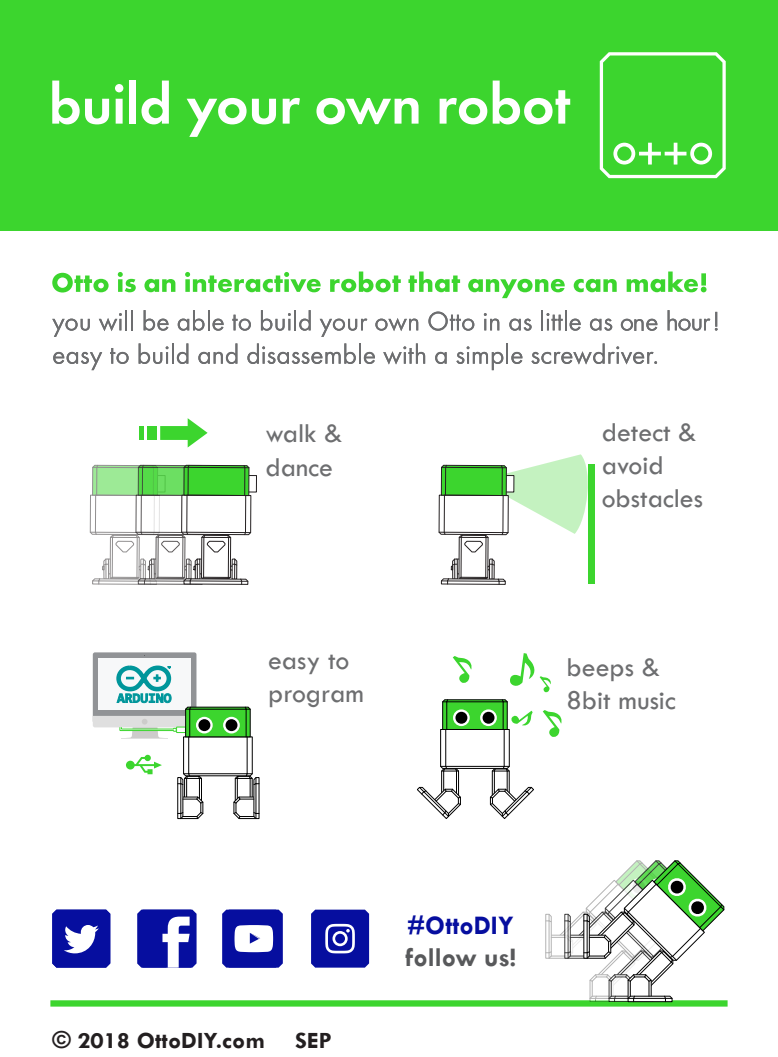
[picture p56: page 2]
beeps & 8bit music; detect & avoid obstacles; walk & dance; easy to program; #OttoDIY follow us!

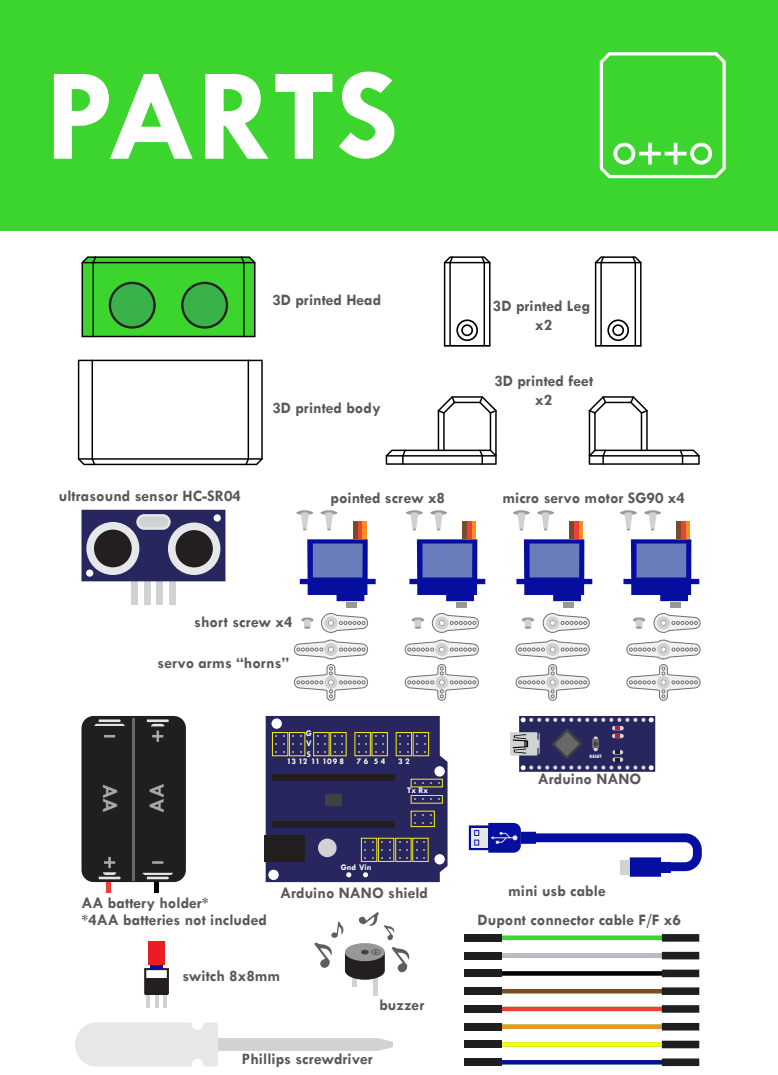
[picture p57: page 3]
Phillips screwdriver; switch 8x8mm; RESET; Gnd Vin; 3D printed Head; Arduino NANO; buzzer; 3D printed body; pointed screw x8; 3D printed Leg x2; short screw x4; 3D printed feet x2

ultrasound sensor HC-SR04

micro servo motor SG90 x4

servo arms “horns”

Arduino NANO shield

mini usb cable
Dupont connector cable F/F x6

AA battery holder*
*4AA batteries not included

a

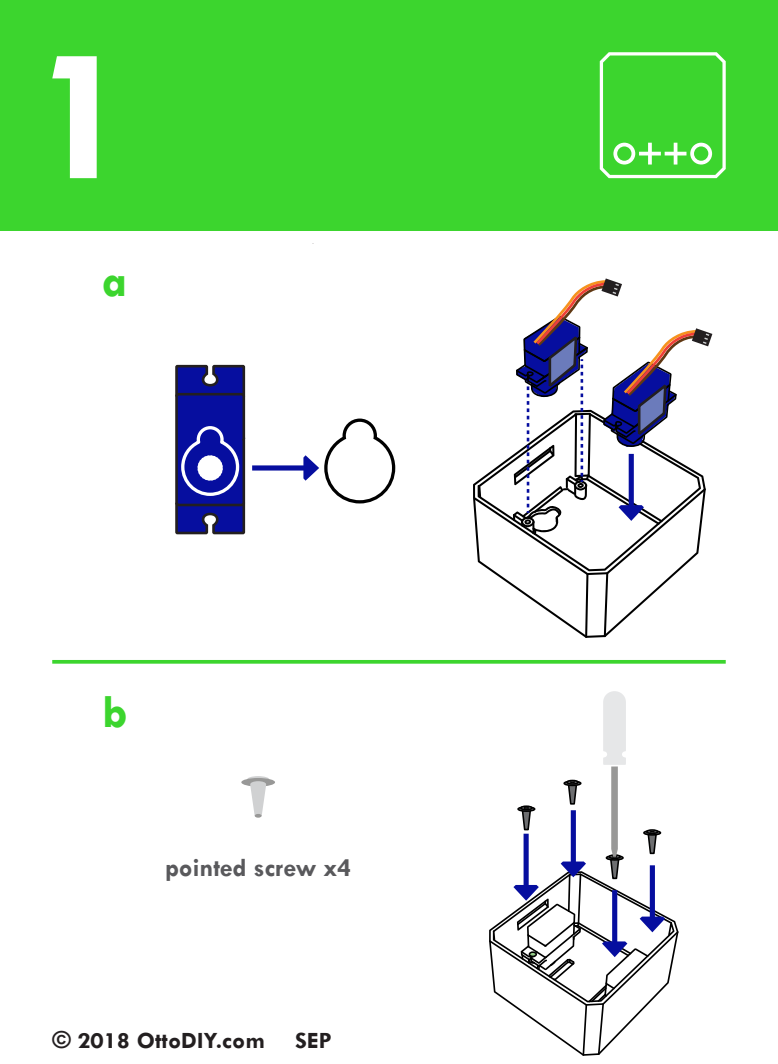
[picture p58: page 4]
pointed screw x4

a

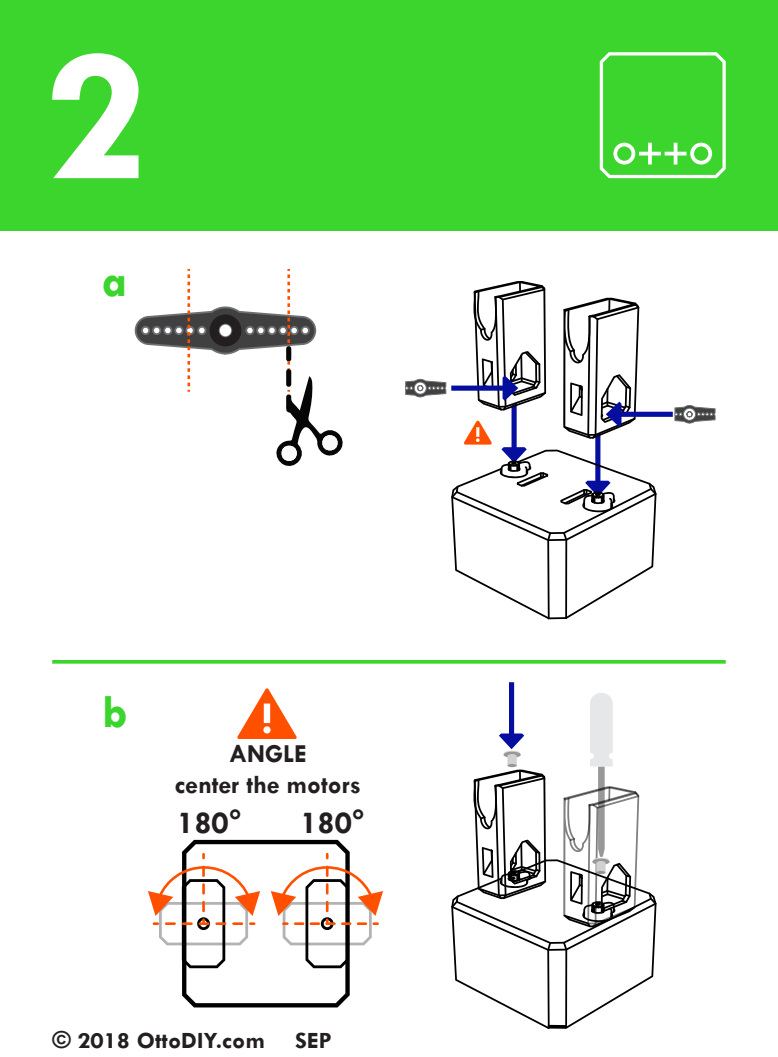
[picture p59: page 5]

ANGLE
center the motors

a

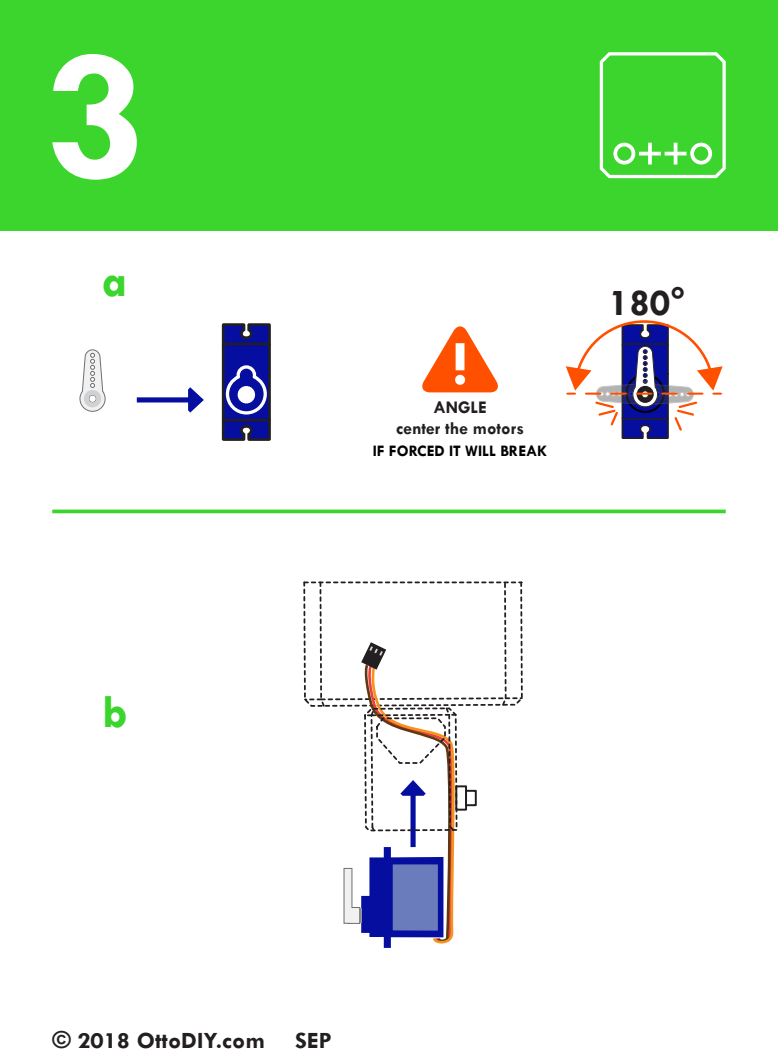
[picture p60: page 6]

ANGLE
center the motors
IF FORCED IT WILL BREAK

a

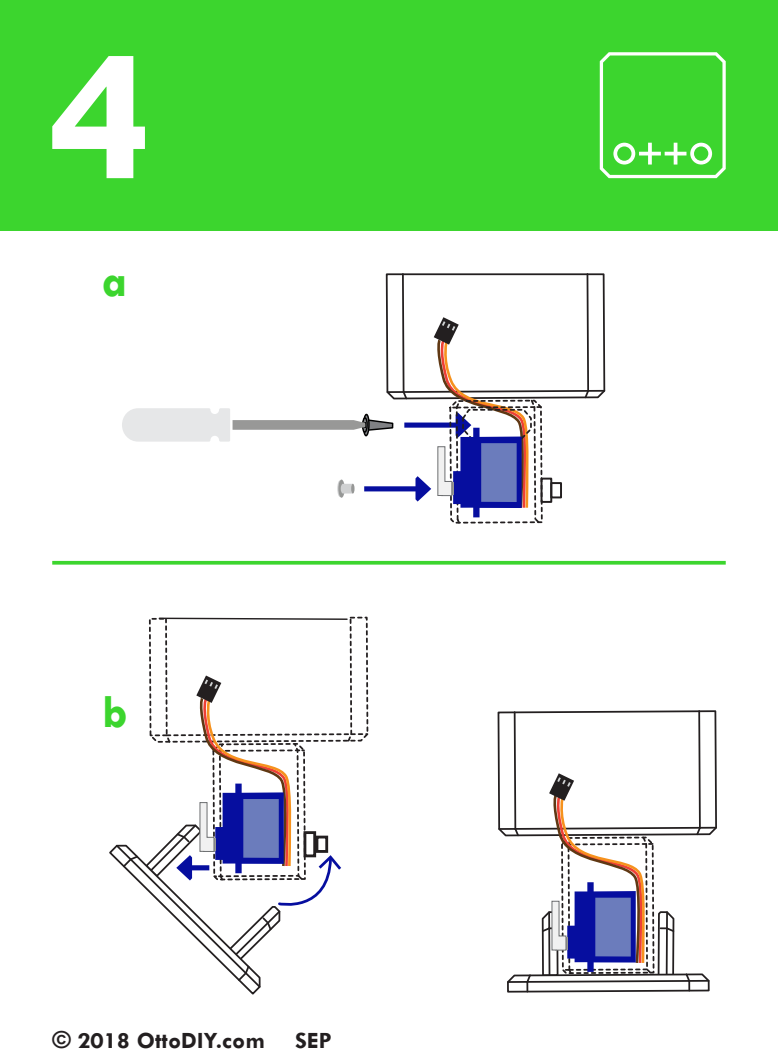
[picture p61: page 7]

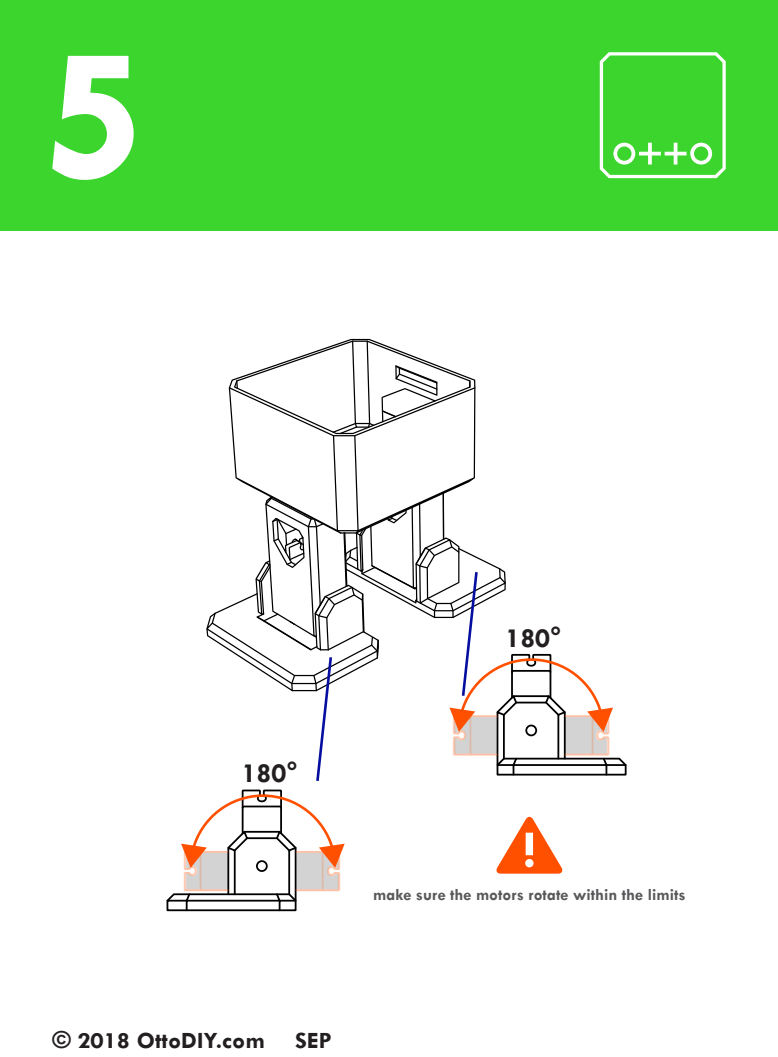
[picture p62: page 8]

make sure the motors rotate within the limits

a

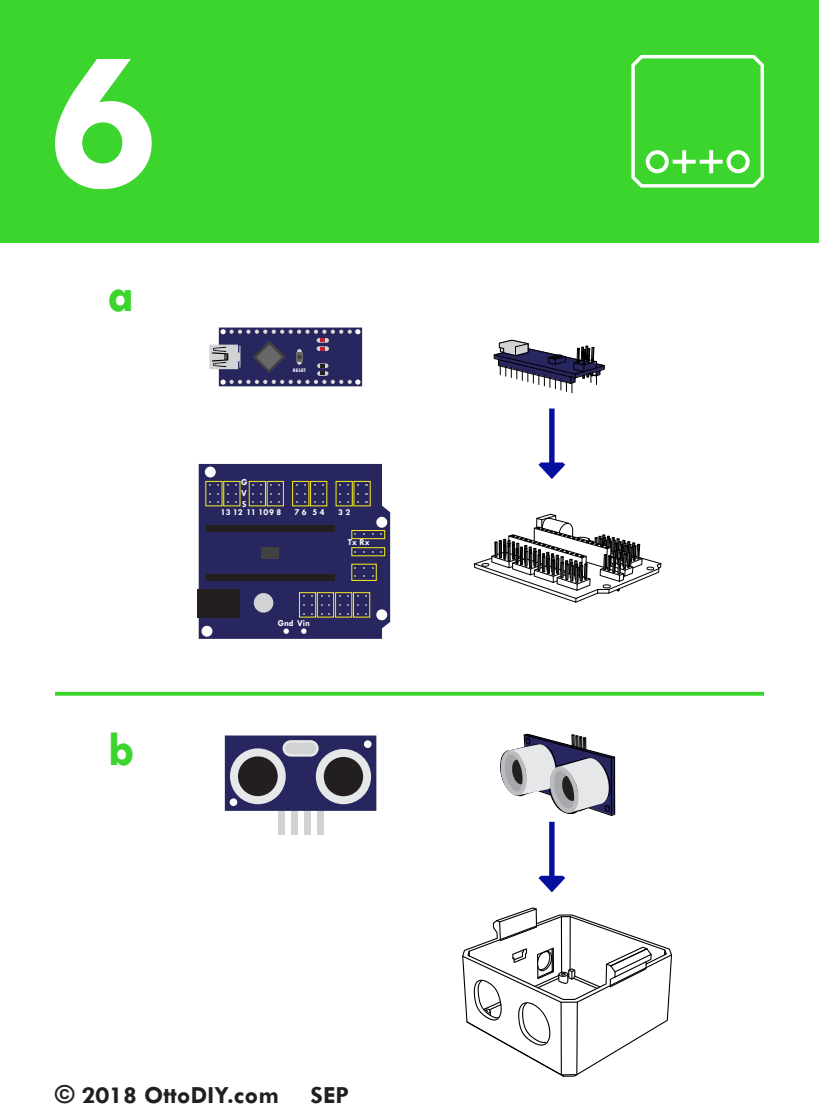
[picture p63: page 9]
RESET; Gnd Vin

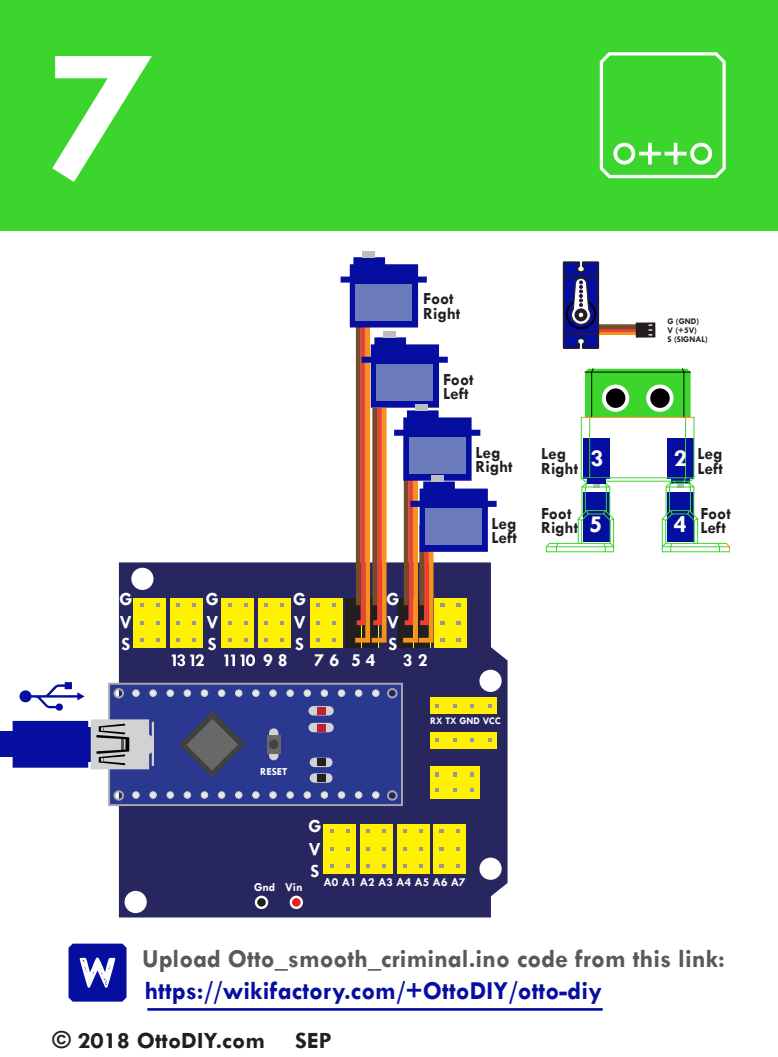
[picture p64: page 10]
RESET; Gnd Vin; Foot Right; Leg; Left Leg Right; Foot Left; Leg Left; Leg Right; G (GND) V (+5V) S (SIGNAL)

RX TX GND VCC

Upload Otto_smooth_criminal.ino code from this link:
https://wikifactory.com/+OttoDIY/otto-diy

a

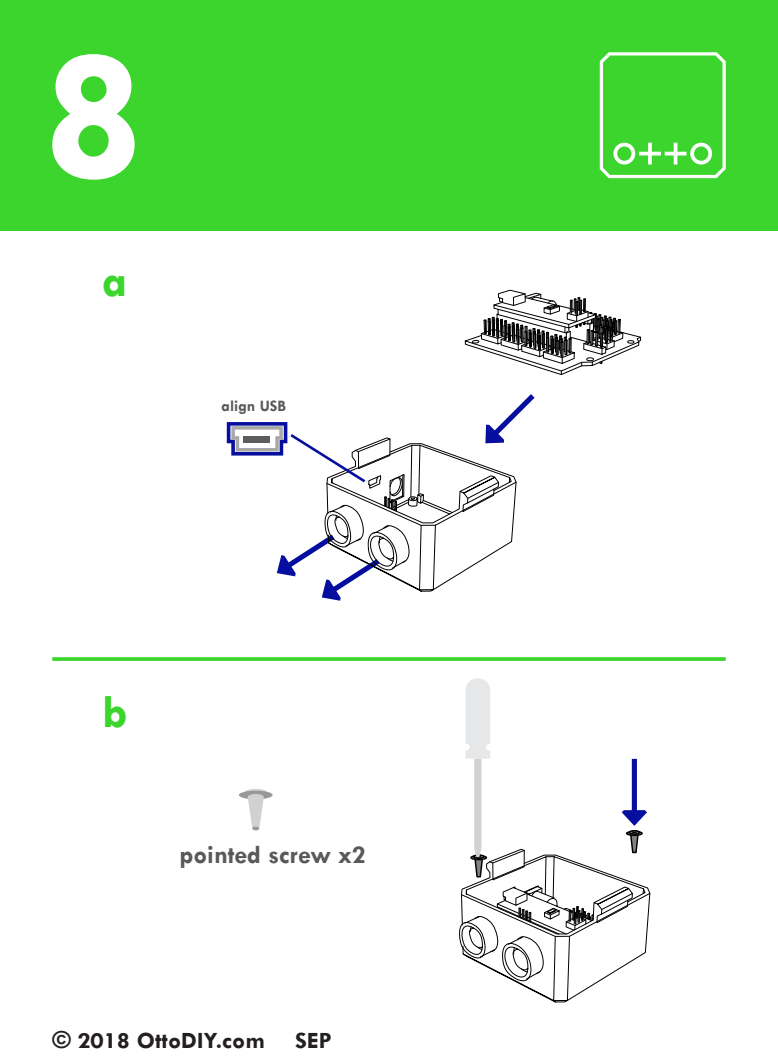
[picture p65: page 11]
align USB; pointed screw x2

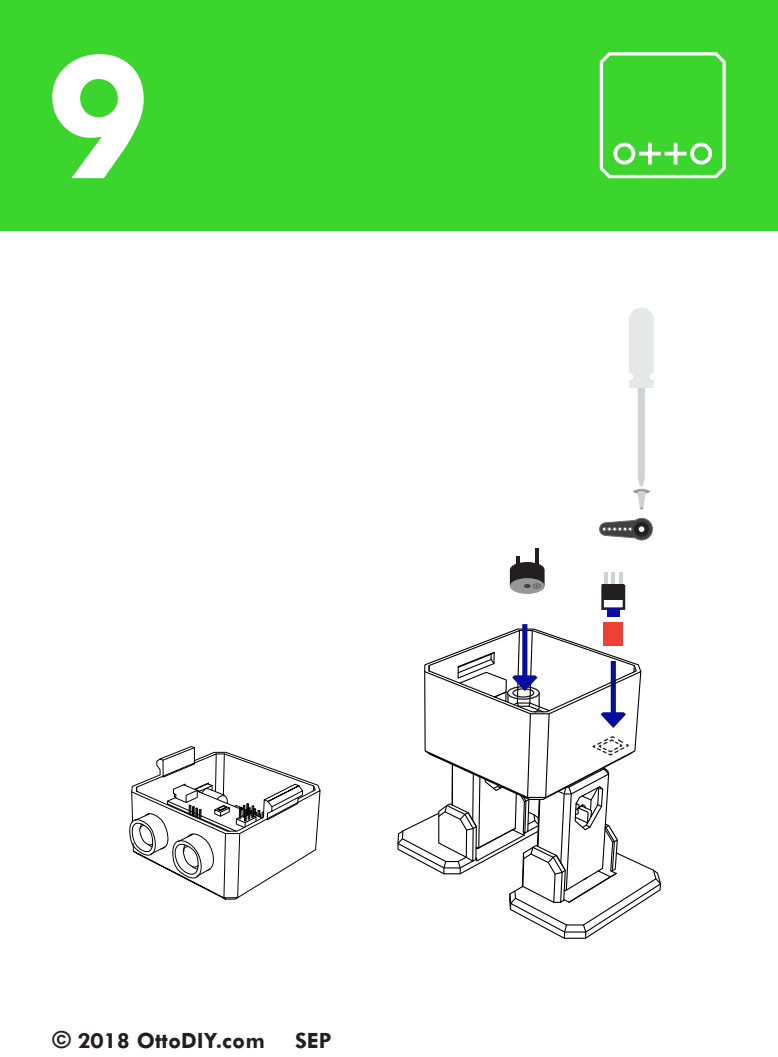
[picture p66: page 12]

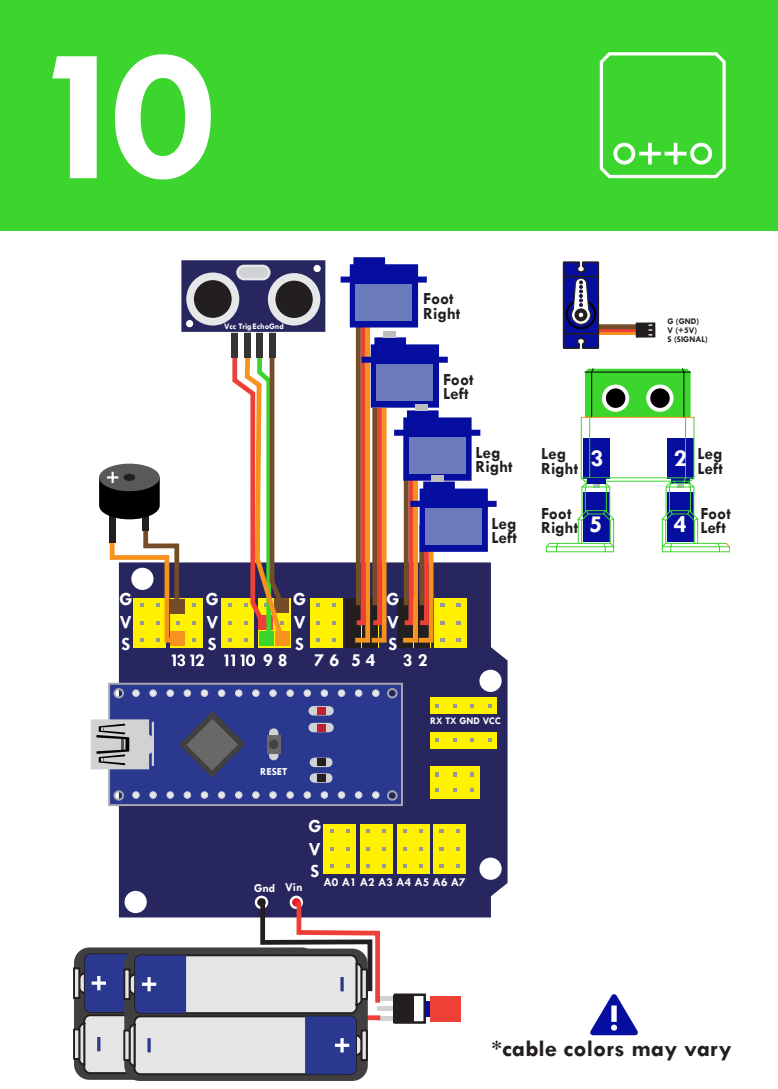
[picture p67: page 13]
RESET; Gnd Vin; Foot Right; Leg; Left Leg Right; Foot Left; Vcc TrigEchoGnd; Leg Left; Leg Right; G (GND) V (+5V) S (SIGNAL)

RX TX GND VCC

*cable colors may vary

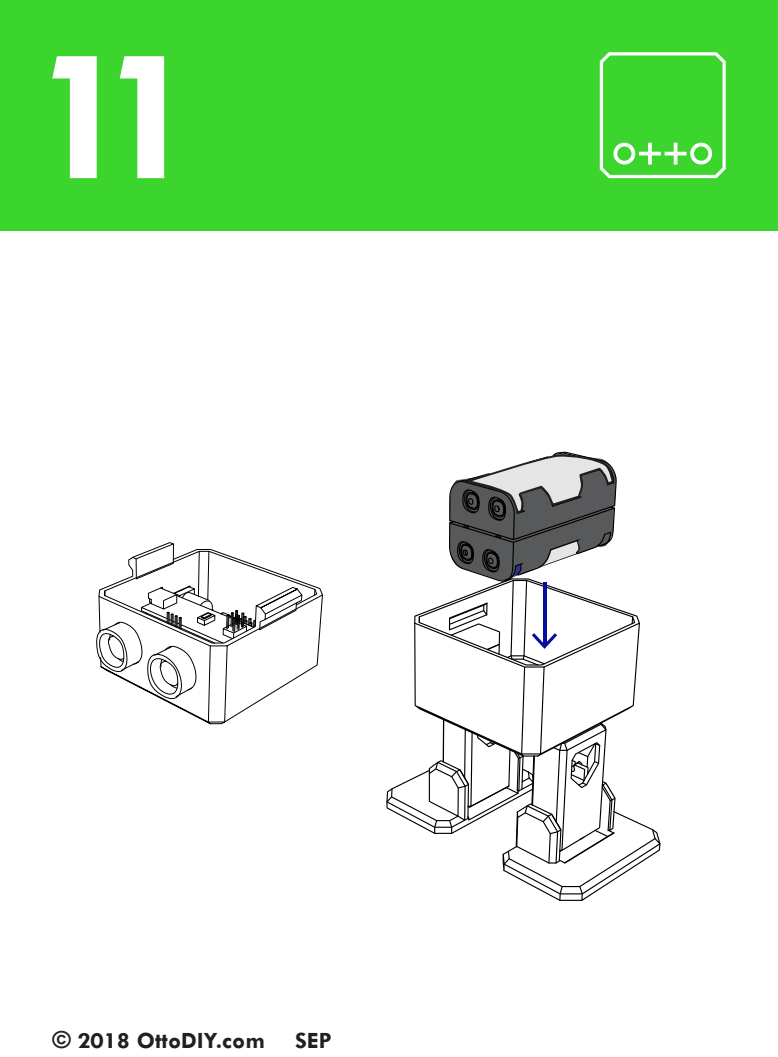
[picture p68: page 14]

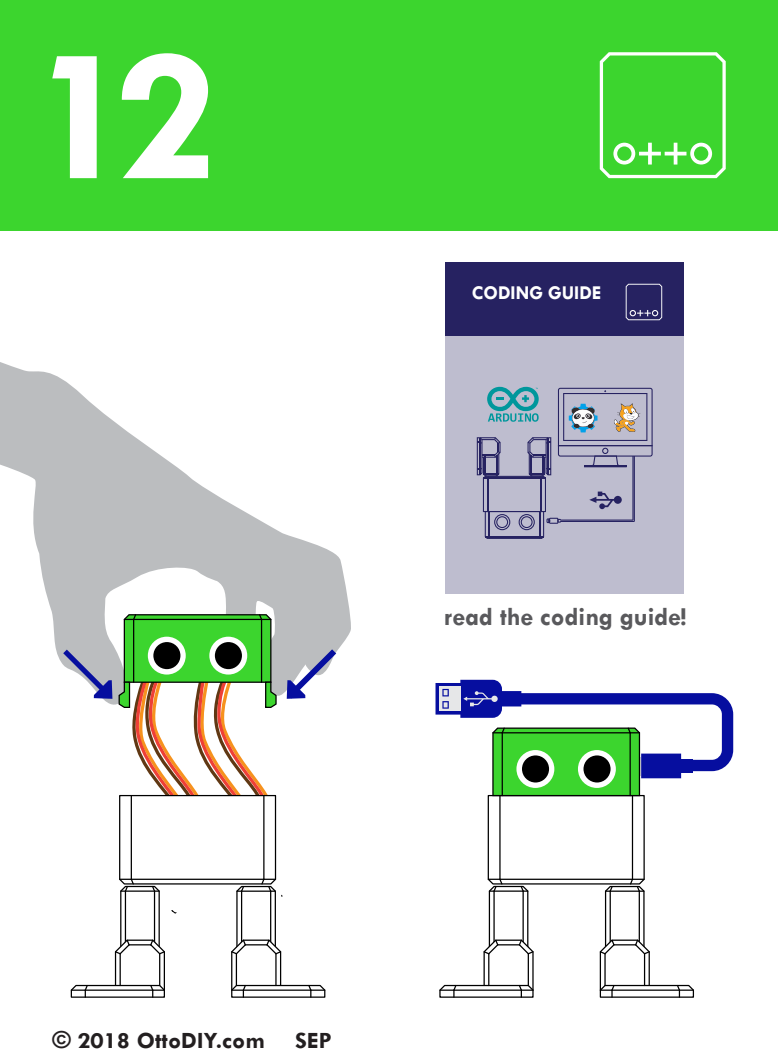
[picture p69: page 15]
CODING GUIDE

read the coding guide!

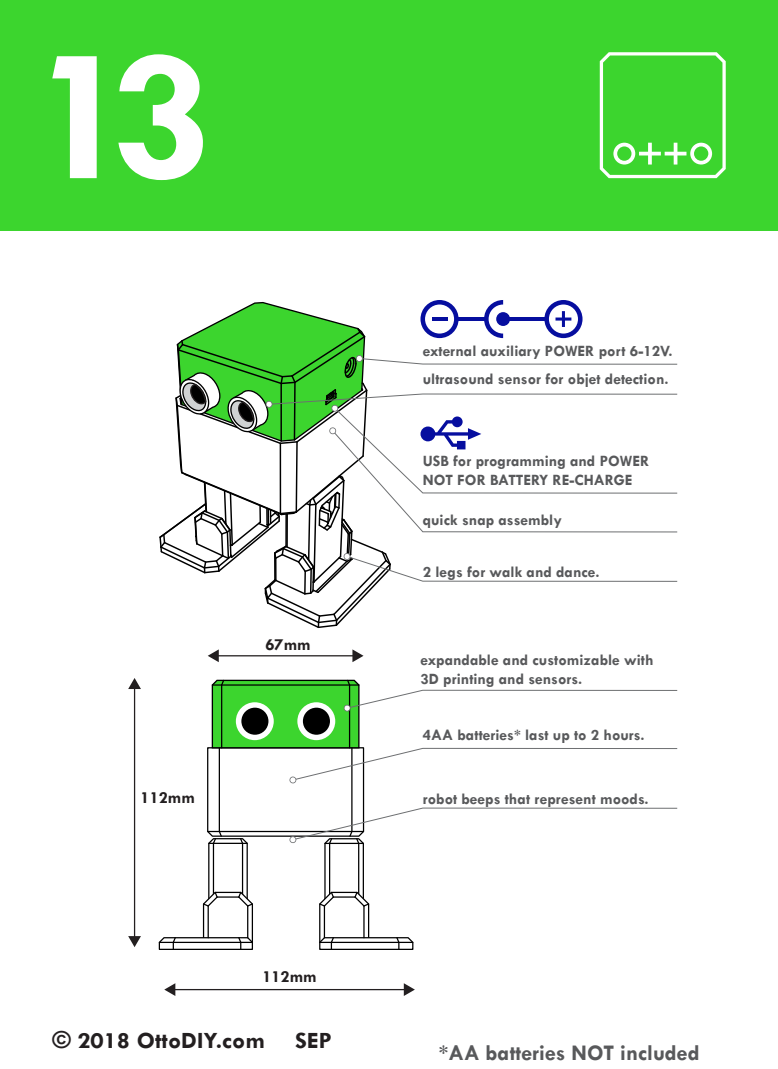
[picture p70: page 16]

external auxiliary POWER port 6-12V.
ultrasound sensor for objet detection.

USB for programming and POWER
NOT FOR BATTERY RE-CHARGE

quick snap assembly

2 legs for walk and dance.

expandable and customizable with
3D printing and sensors.

4AA batteries* last up to 2 hours.

robot beeps that represent moods.

*AA batteries NOT included © 2018 OttoDIY.com SEP

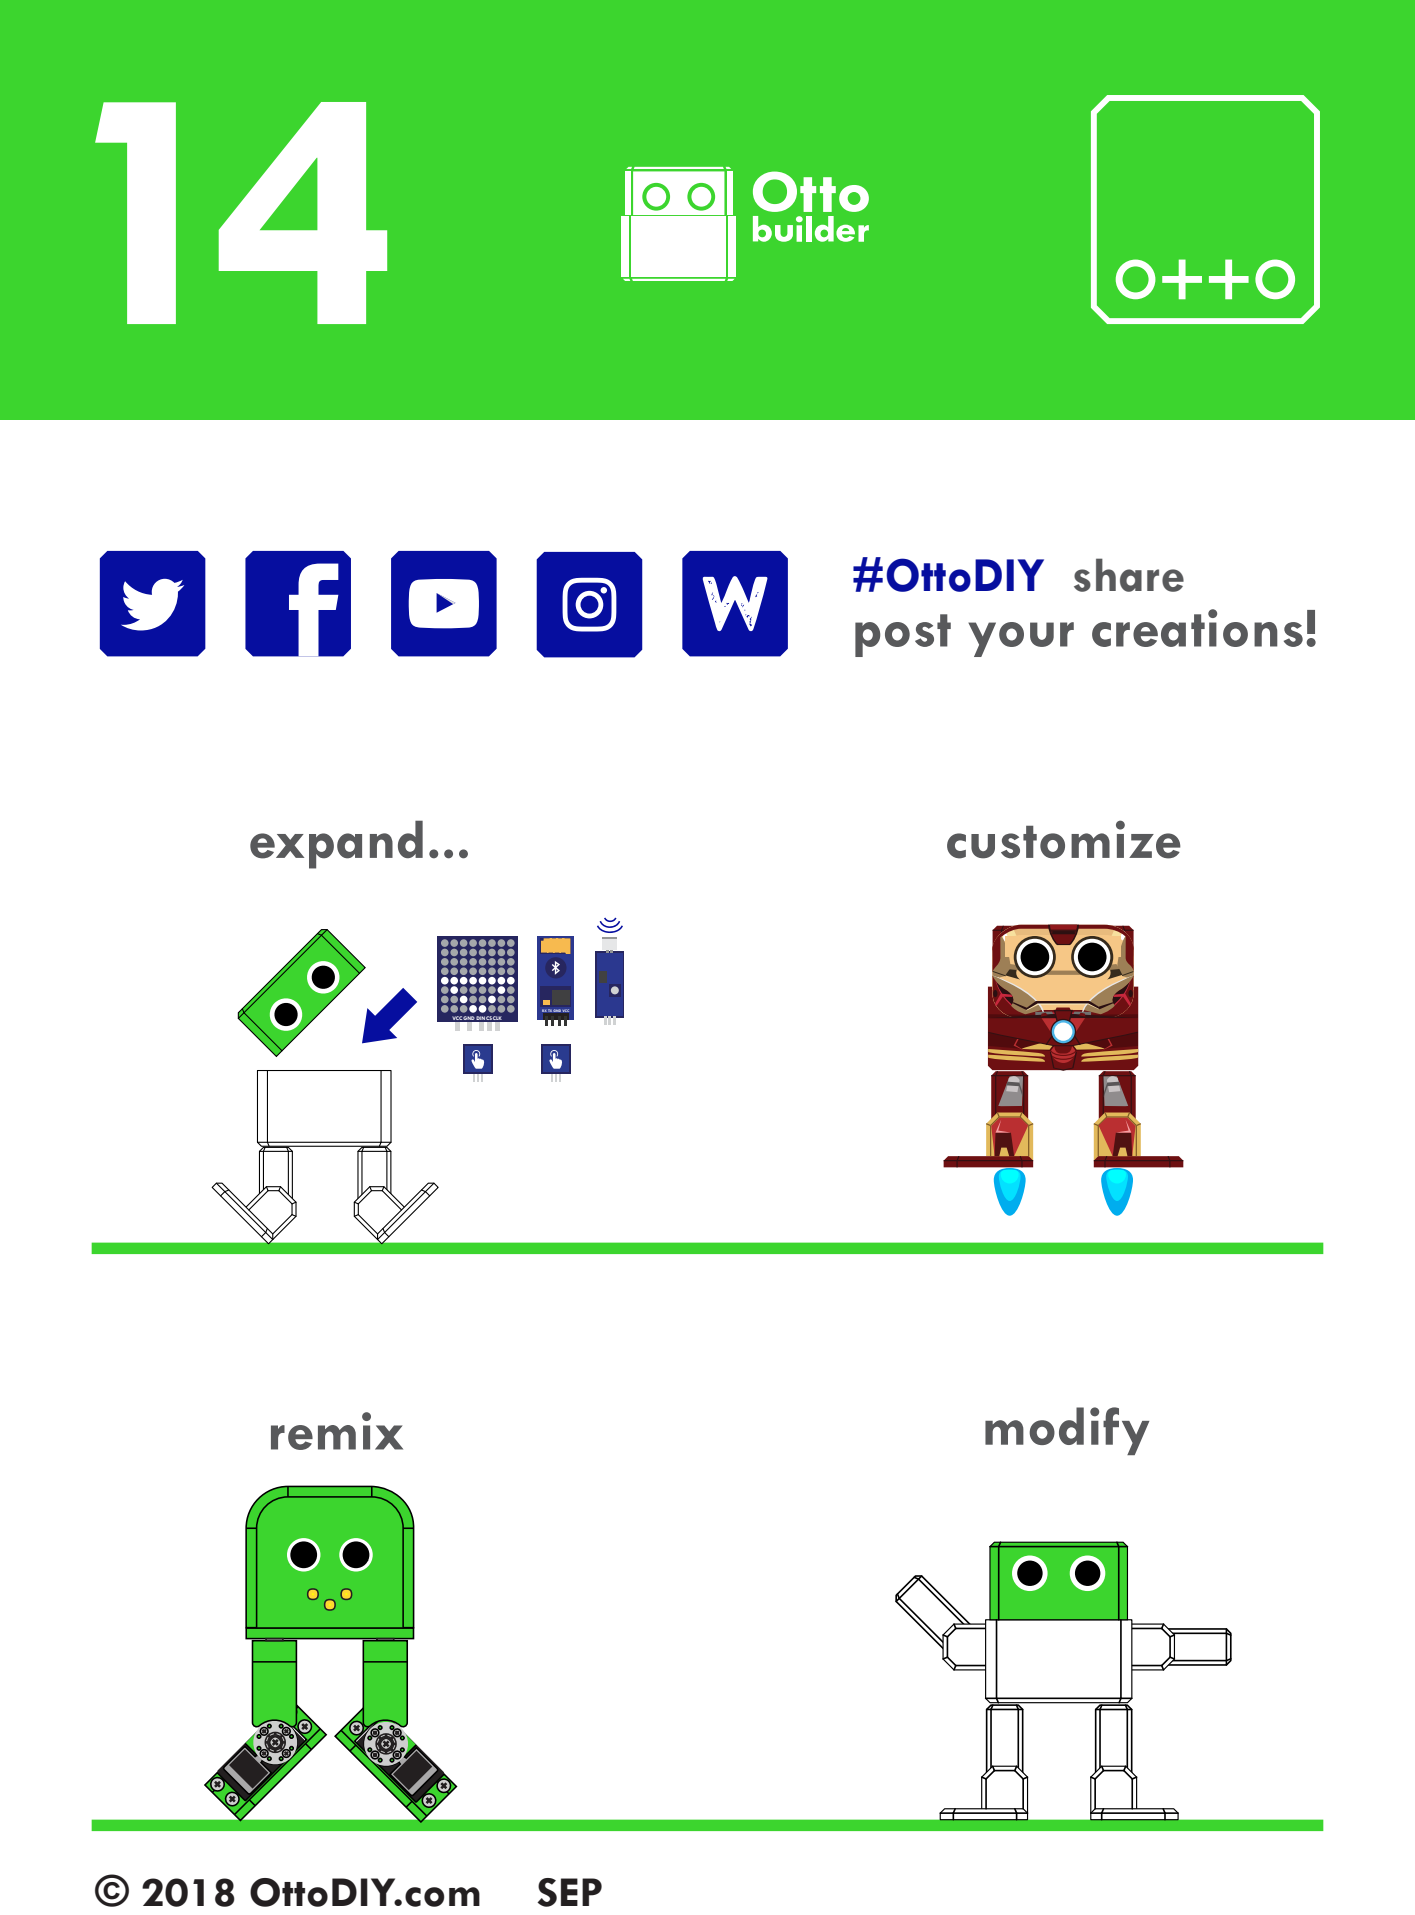
[picture p71: page 17]
remix; expand...; customize; modify

#OttoDIY share
post your creations!

VCC GND DINCSCLK

RX TX GND VCC

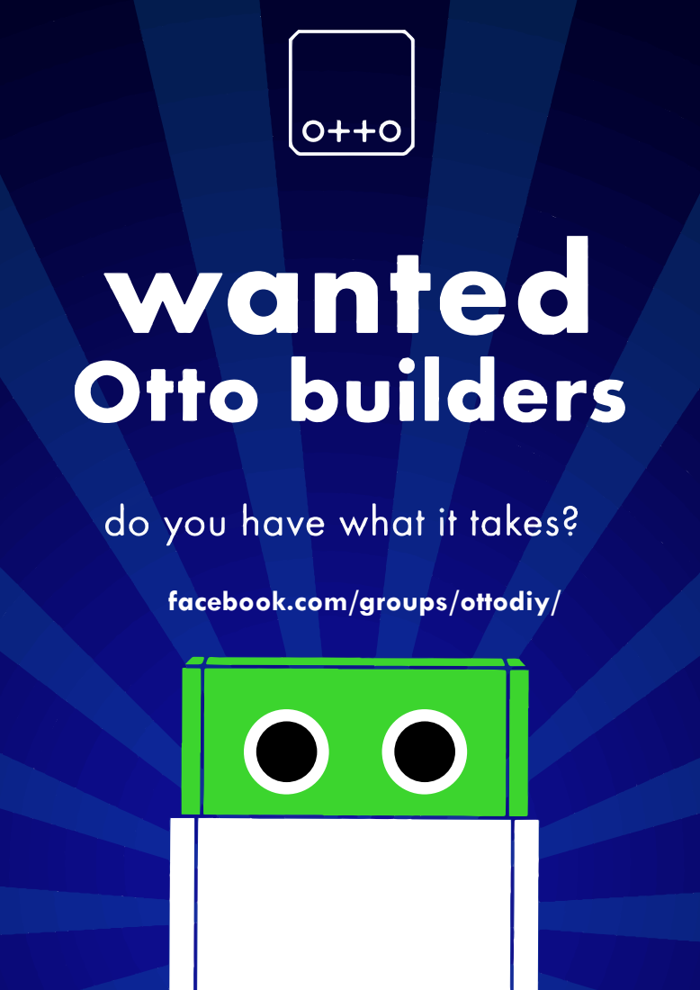
[picture p72: page 18]

facebook.com/groups/ottodiy/
